BornaBiro/ESP32_WeatherPaper/Images/20211017_192531.jpg

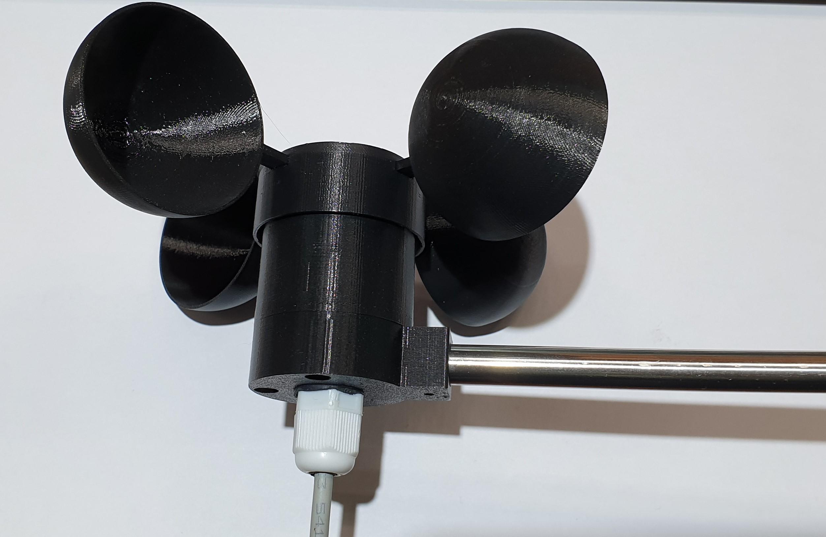
Images/20211017_192531.jpg
