BornaBiro/ESP32_WeatherPaper/Outdoor Unit Files/3D Models/FreeCAD files/WindSpeed/Notes.txt

- IR Interupter used: https://soldered.com/product/photointerrupter-itr9608/
- Wind Cups: 15% infil, 4 perimeters minimum, 0.1mm layers, black PETG (MUST BE BLACK!)
