BornaBiro/ESP32_WeatherPaper/Images/20211017_200331.jpg

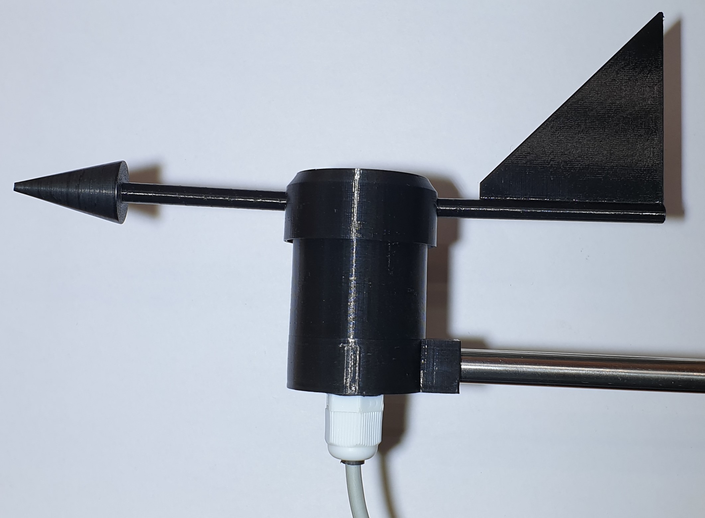
Images/20211017_200331.jpg
