BornaBiro/ESP32_WeatherPaper/Images/20220807_165750.jpg

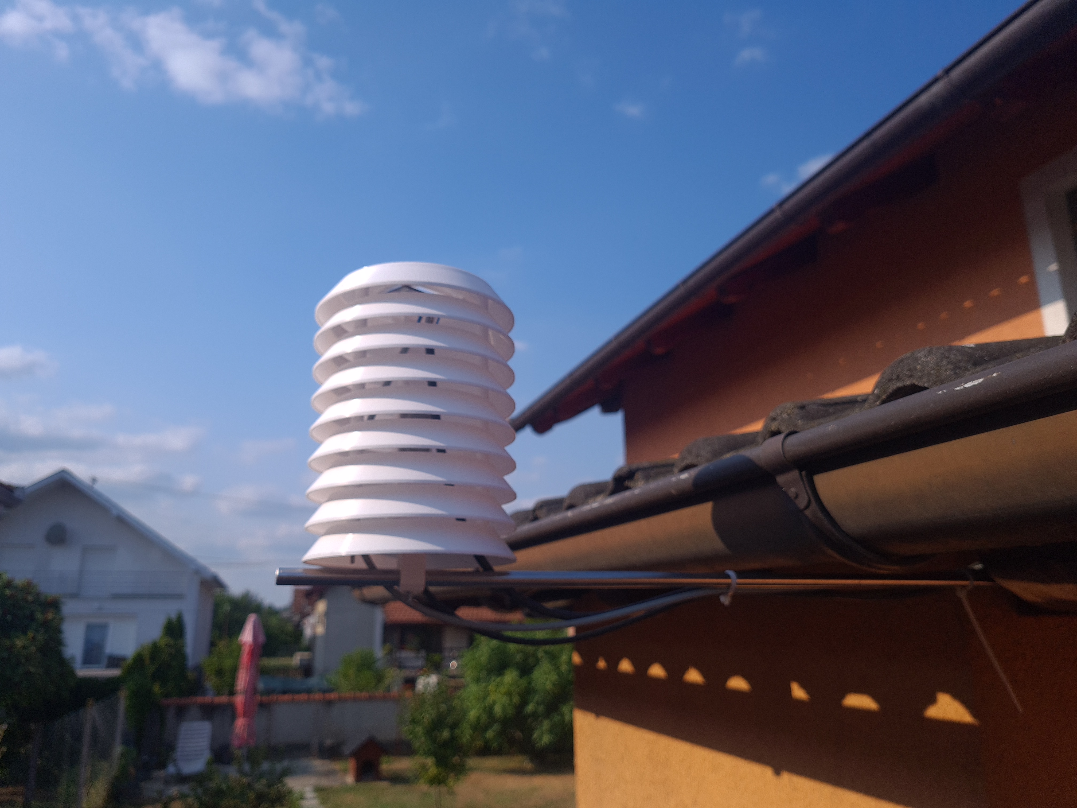
Images/20220807_165750.jpg
