BornaBiro/ESP32_WeatherPaper/Images/20220807_165809.jpg

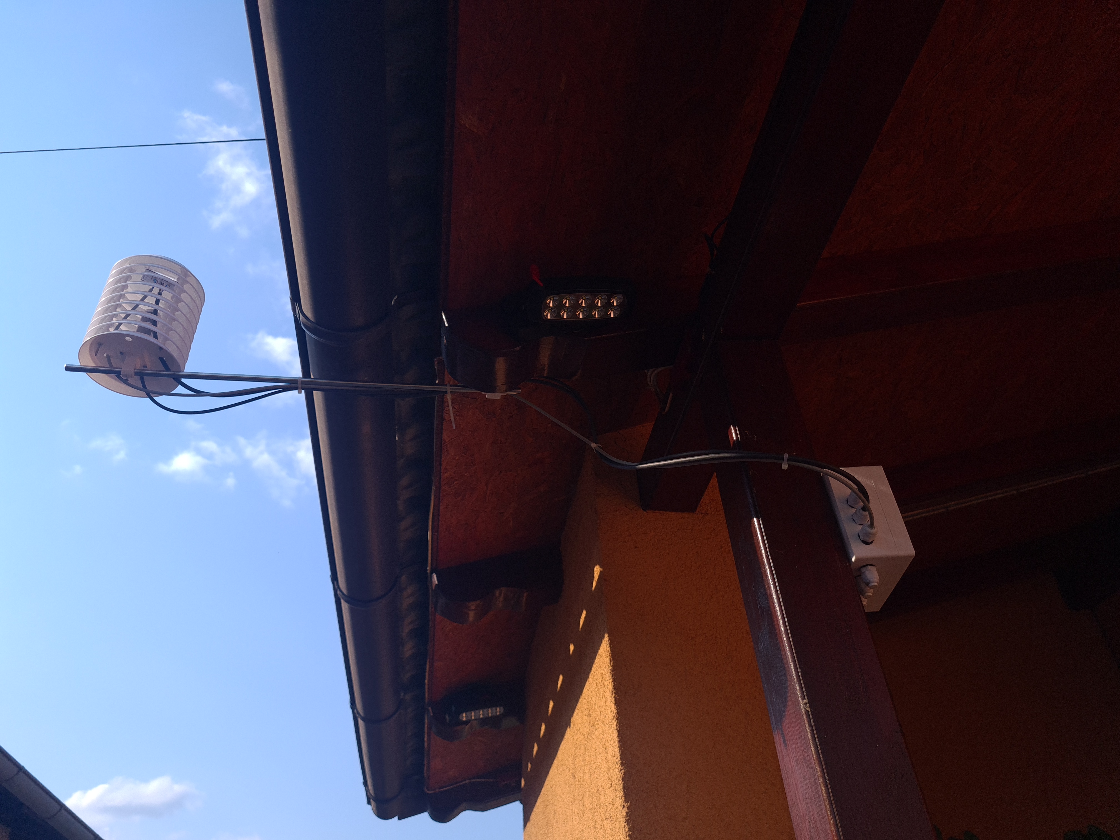
Images/20220807_165809.jpg
