BornaBiro/ESP32_WeatherPaper/Images/20220807_165829.jpg

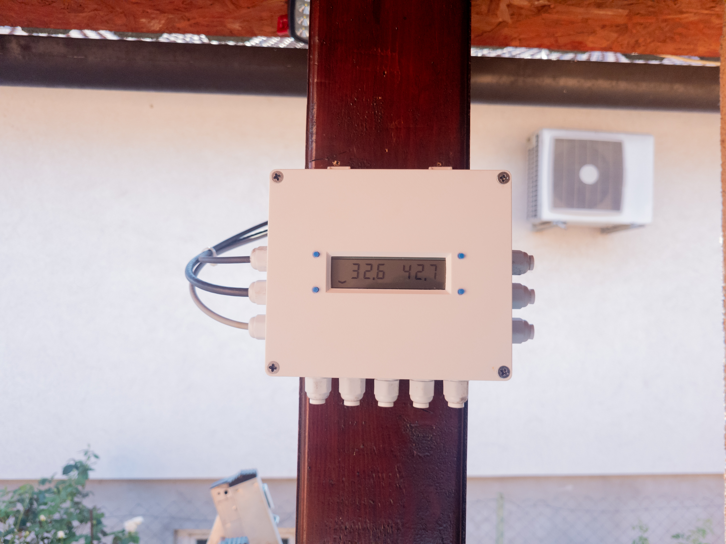
Images/20220807_165829.jpg
