BornaBiro/ESP32_WeatherPaper/Images/IMG_20220727_213647_678.jpg

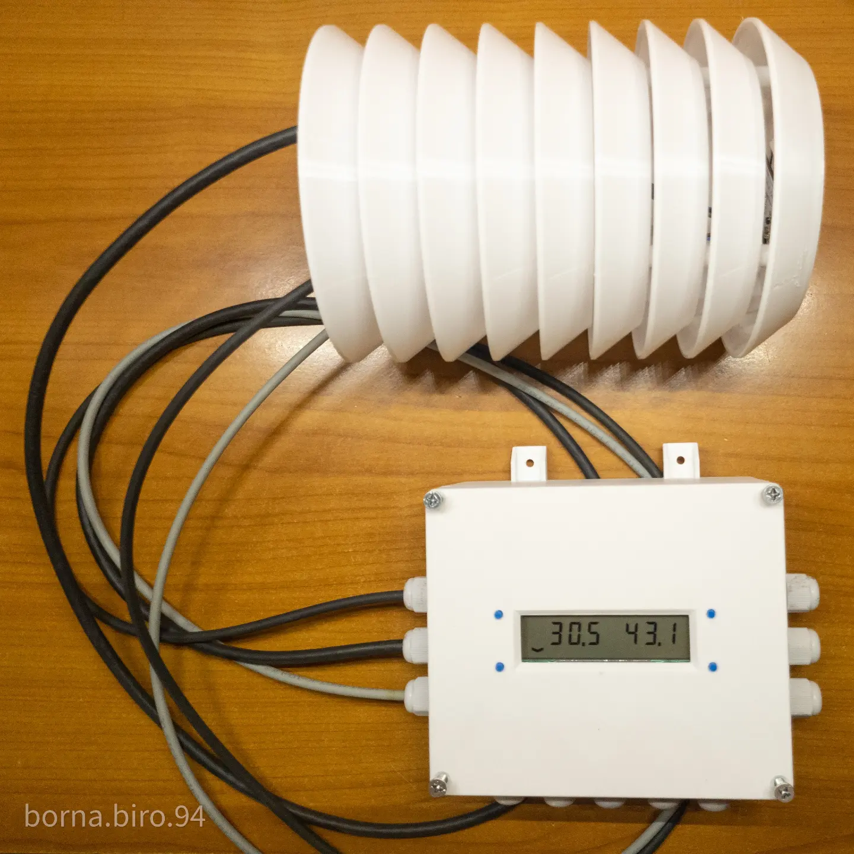
Images/IMG_20220727_213647_678.jpg
