BornaBiro/ESP32_WeatherPaper/Images/IMG_20220727_213647_747.jpg

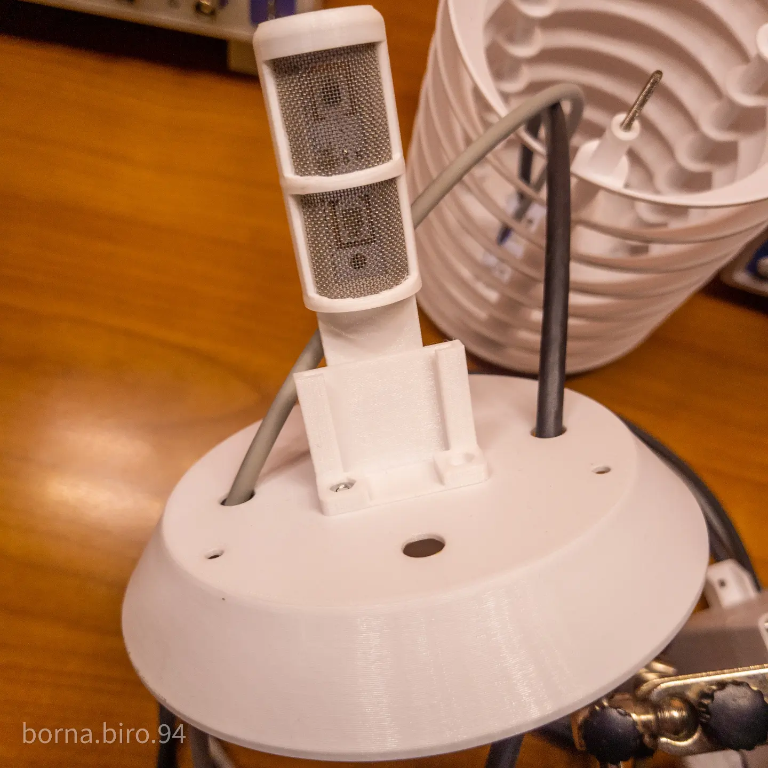
Images/IMG_20220727_213647_747.jpg
