BornaBiro/ESP32_WeatherPaper/Images/IMG_20220727_213647_826.jpg

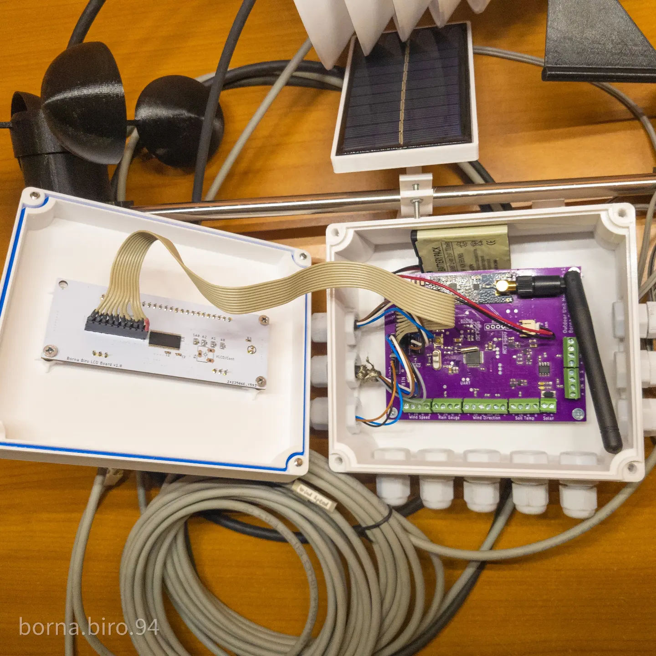
Images/IMG_20220727_213647_826.jpg
