BornaBiro/ESP32_WeatherPaper/Images/PSX_20211029_150437.jpg

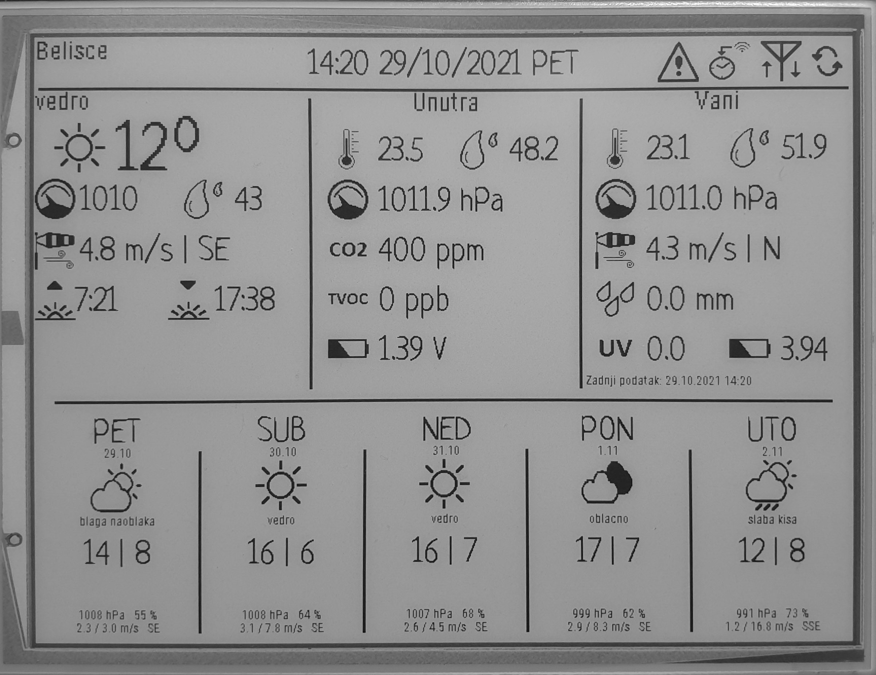
Images/PSX_20211029_150437.jpg
