BornaBiro/ESP32_WeatherPaper/Images/PSX_20211029_150859.jpg

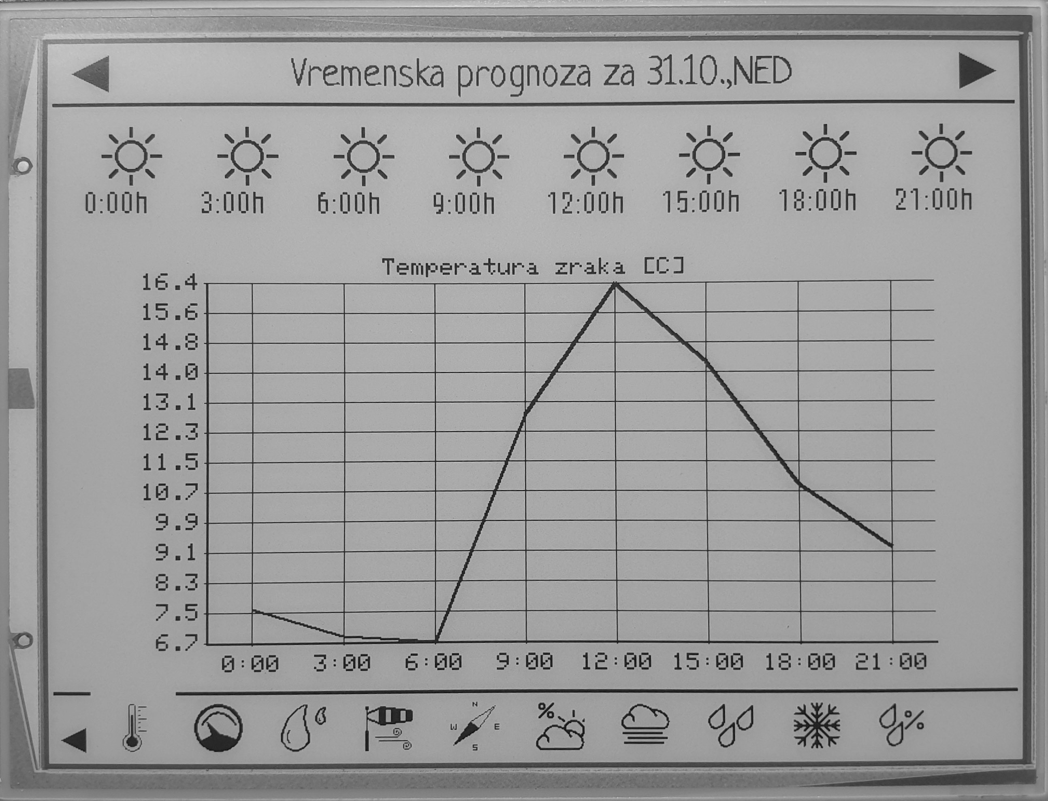
Images/PSX_20211029_150859.jpg
