BornaBiro/ESP32_WeatherPaper/Images/PSX_20211029_155932.jpg

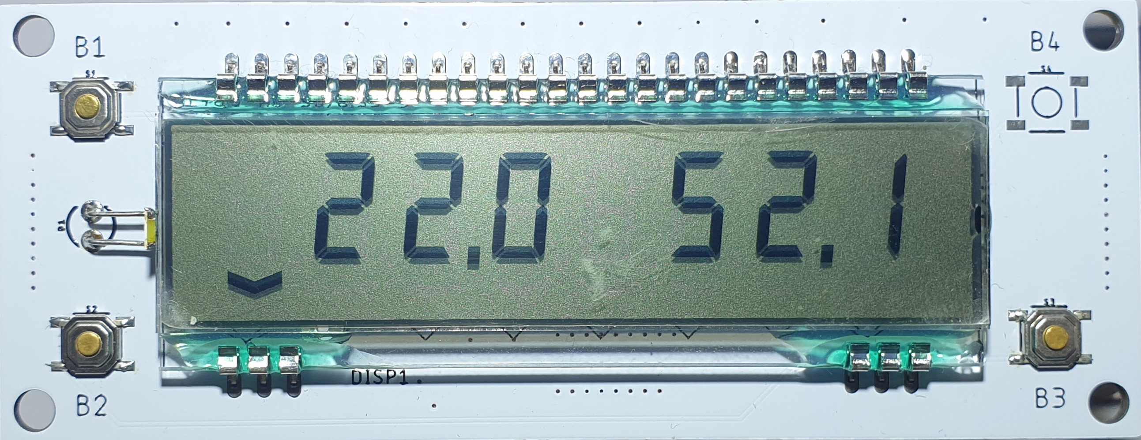
Images/PSX_20211029_155932.jpg
