BornaBiro/ESP32_WeatherPaper/Indoor Unit Files/Case, 3D models/FreeCAD files/Indoor_unit_solar.FCStd

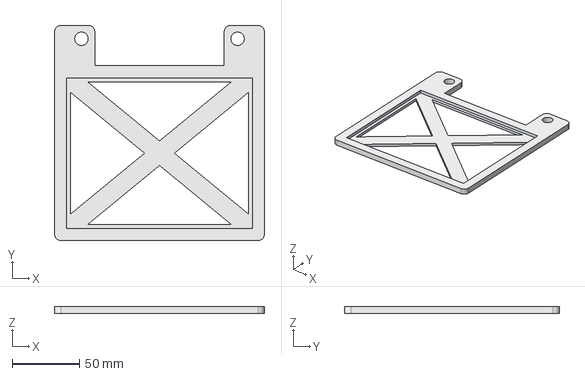
[picture p15: CAD file, 2022-05-21]
Indoor Unit Files/Case, 3D models/FreeCAD files/Indoor_unit_solar.FCStd
156.0 x 160.0 x 5.50 mm
