BornaBiro/ESP32_WeatherPaper/Outdoor Unit Files/3D Models/FreeCAD files/Outdoor Unit Case/button_v2.FCStd

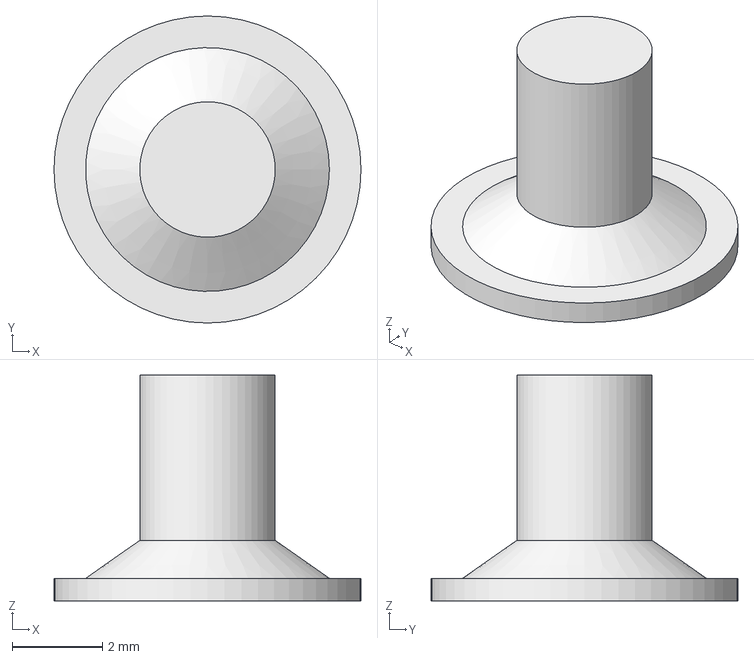
[picture p16: CAD file, 2023-01-04]
Outdoor Unit Files/3D Models/FreeCAD files/Outdoor Unit Case/button_v2.FCStd
6.80 x 6.80 x 5.00 mm
