BornaBiro/ESP32_WeatherPaper/Outdoor Unit Files/3D Models/FreeCAD files/Radiation Shield/Stevenson_screen_v2_top.FCStd

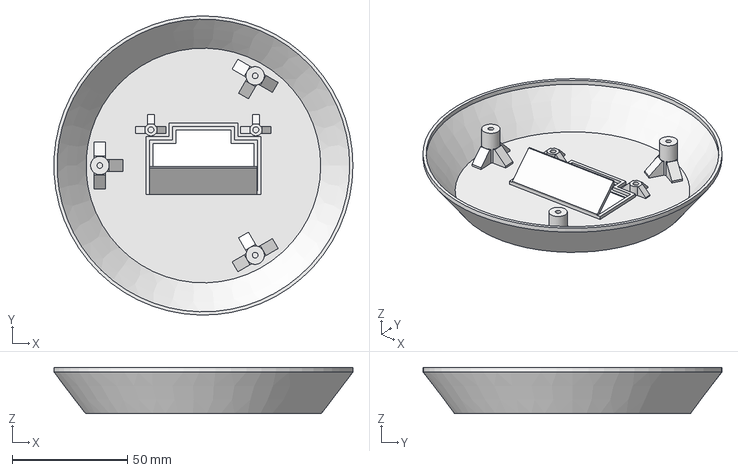
[picture p17: CAD file, 2023-01-04]
Outdoor Unit Files/3D Models/FreeCAD files/Radiation Shield/Stevenson_screen_v2_top.FCStd
129.9 x 130.0 x 20.0 mm
