BornaBiro/ESP32_WeatherPaper/Outdoor Unit Files/3D Models/FreeCAD files/Solar Panel/solar_panel_clip.FCStd

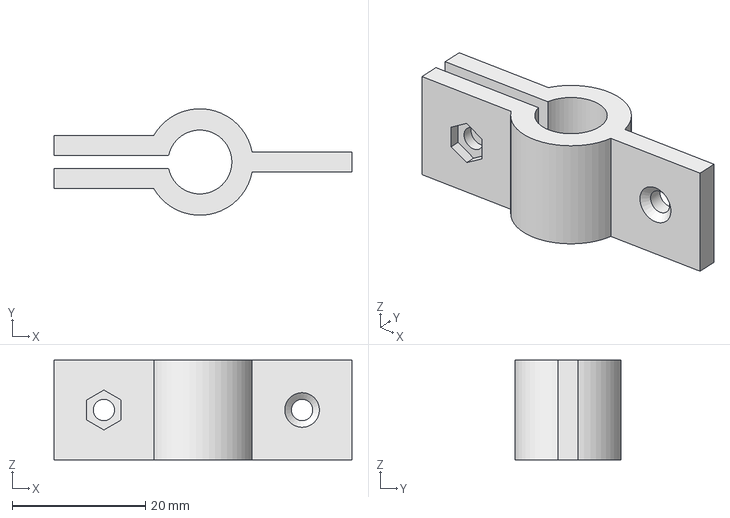
[picture p18: CAD file, 2023-01-04]
Outdoor Unit Files/3D Models/FreeCAD files/Solar Panel/solar_panel_clip.FCStd
44.8 x 16.0 x 15.0 mm
