BornaBiro/ESP32_WeatherPaper/Outdoor Unit Files/3D Models/FreeCAD files/WindDirection/windDirectionSensorHousing.FCStd

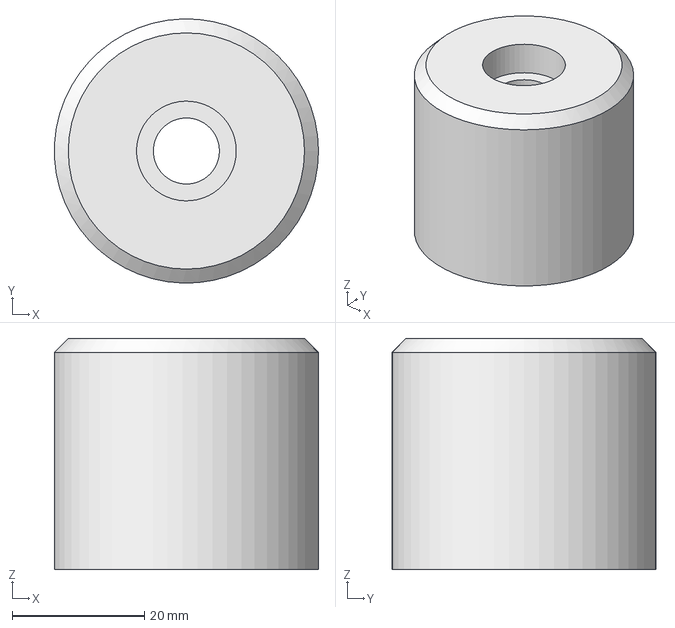
[picture p19: CAD file, 2023-01-04]
Outdoor Unit Files/3D Models/FreeCAD files/WindDirection/windDirectionSensorHousing.FCStd
40.0 x 40.0 x 35.0 mm
