BornaBiro/ESP32_WeatherPaper/Indoor Unit Files/Case, 3D models/FreeCAD files/epaperFrameV5.FCStd

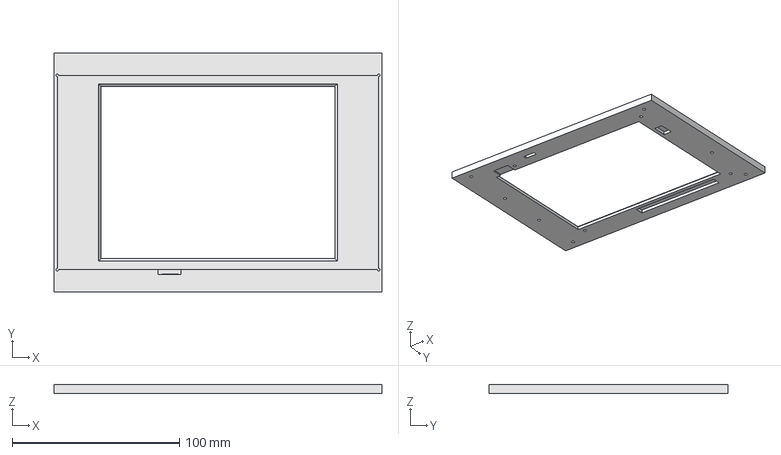
[picture p21: CAD file, 2022-05-21]
Indoor Unit Files/Case, 3D models/FreeCAD files/epaperFrameV5.FCStd
196.0 x 143.0 x 5.50 mm
