BornaBiro/ESP32_WeatherPaper/Outdoor Unit Files/3D Models/FreeCAD files/Outdoor Unit Case/outdoor_unit_case_topv2_1.FCStd

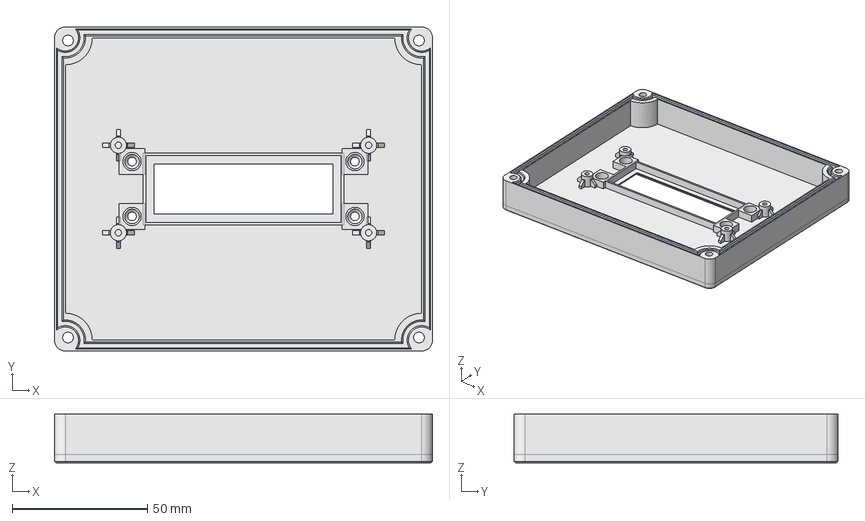
[picture p22: CAD file, 2023-01-04]
Outdoor Unit Files/3D Models/FreeCAD files/Outdoor Unit Case/outdoor_unit_case_topv2_1.FCStd
140.0 x 120.0 x 18.0 mm
