BornaBiro/ESP32_WeatherPaper/Outdoor Unit Files/3D Models/FreeCAD files/Radiation Shield/Stevenson_screen_bottom_v2.FCStd

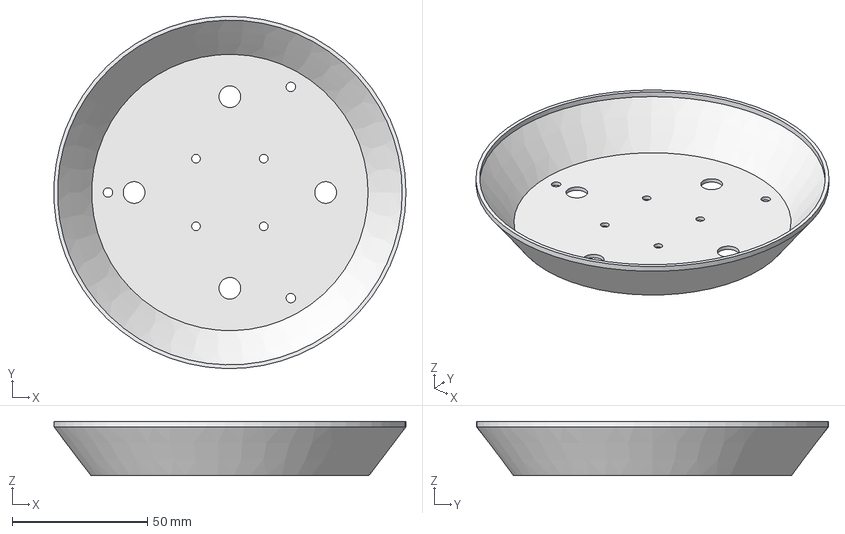
[picture p23: CAD file, 2023-01-04]
Outdoor Unit Files/3D Models/FreeCAD files/Radiation Shield/Stevenson_screen_bottom_v2.FCStd
129.9 x 130.0 x 20.0 mm
