BornaBiro/ESP32_WeatherPaper/Outdoor Unit Files/3D Models/FreeCAD files/Solar Panel/Outdoor_solar_panel.FCStd

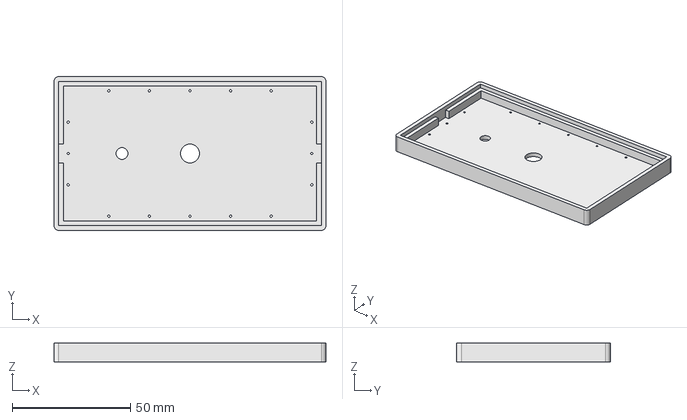
[picture p24: CAD file, 2023-01-04]
Outdoor Unit Files/3D Models/FreeCAD files/Solar Panel/Outdoor_solar_panel.FCStd
115.0 x 65.0 x 8.00 mm
