BornaBiro/ESP32_WeatherPaper/Outdoor Unit Files/3D Models/FreeCAD files/WindDirection/windDirectionArrowTopv2.FCStd

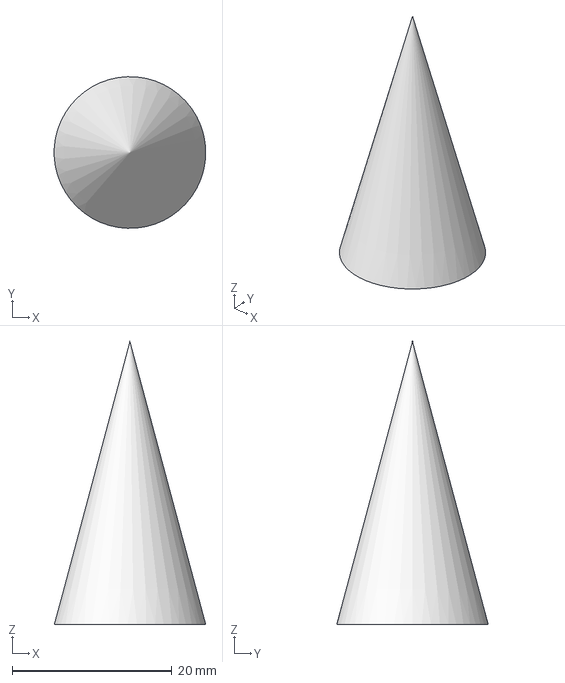
[picture p25: CAD file, 2023-01-04]
Outdoor Unit Files/3D Models/FreeCAD files/WindDirection/windDirectionArrowTopv2.FCStd
19.0 x 19.0 x 35.5 mm
