BornaBiro/ESP32_WeatherPaper/Outdoor Unit Files/3D Models/FreeCAD files/WindSpeed/windSensorHousingBottomv2.FCStd

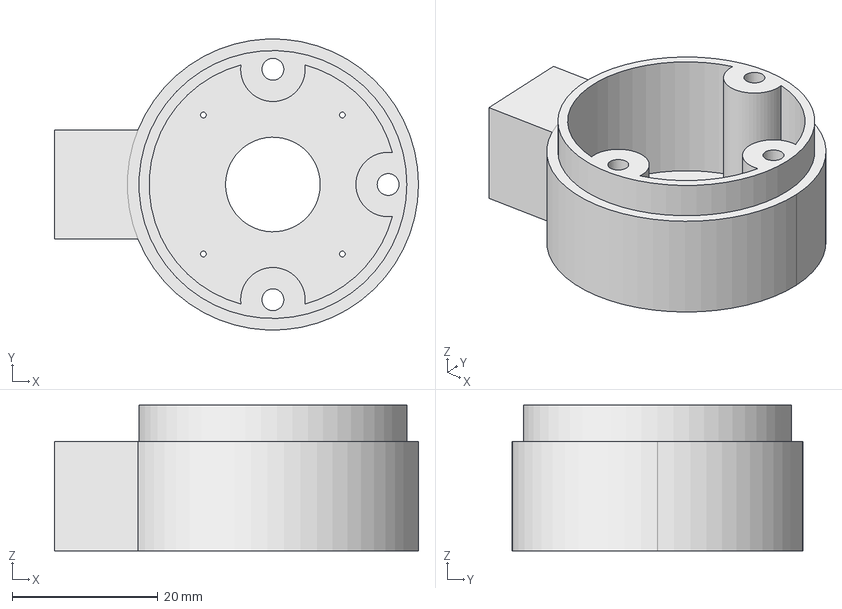
[picture p26: CAD file, 2023-01-04]
Outdoor Unit Files/3D Models/FreeCAD files/WindSpeed/windSensorHousingBottomv2.FCStd
50.0 x 40.0 x 20.0 mm
