BornaBiro/ESP32_WeatherPaper/Indoor Unit Files/Case, 3D models/FreeCAD files/epaperFrameBackCover.FCStd

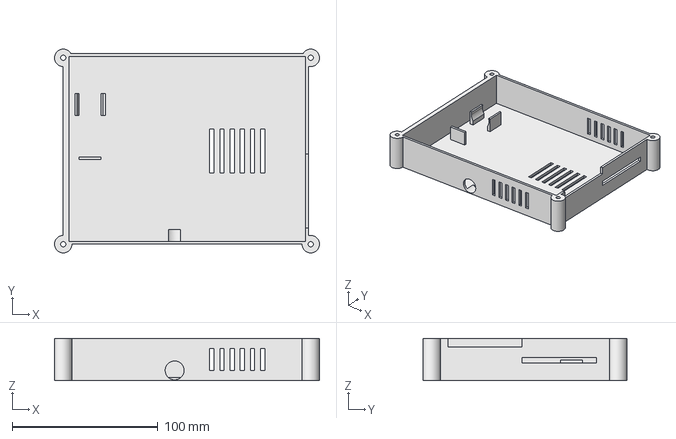
[picture p27: CAD file, 2022-05-21]
Indoor Unit Files/Case, 3D models/FreeCAD files/epaperFrameBackCover.FCStd
182.0 x 140.0 x 29.0 mm
