BornaBiro/ESP32_WeatherPaper/Outdoor Unit Files/3D Models/FreeCAD files/Radiation Shield/Stevenson_screen_middle_v1.FCStd

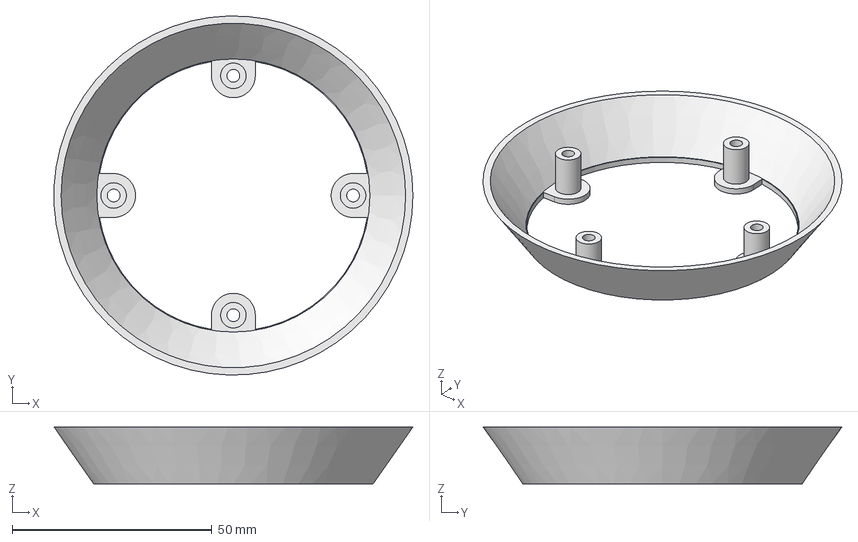
[picture p28: CAD file, 2023-01-04]
Outdoor Unit Files/3D Models/FreeCAD files/Radiation Shield/Stevenson_screen_middle_v1.FCStd
89.9 x 90.0 x 14.3 mm
