BornaBiro/ESP32_WeatherPaper/Outdoor Unit Files/3D Models/FreeCAD files/Solar Panel/Ball_joint1.FCStd

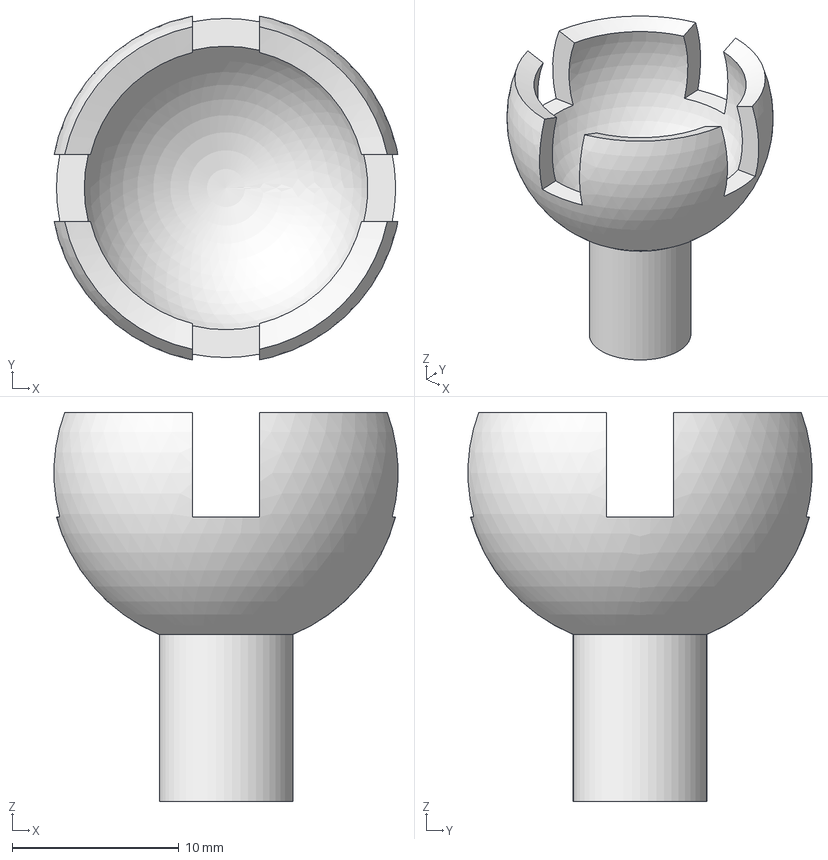
[picture p29: CAD file, 2023-01-04]
Outdoor Unit Files/3D Models/FreeCAD files/Solar Panel/Ball_joint1.FCStd
20.6 x 20.6 x 23.3 mm
