BornaBiro/ESP32_WeatherPaper/Outdoor Unit Files/3D Models/FreeCAD files/WindDirection/windDIrectionShaft.FCStd

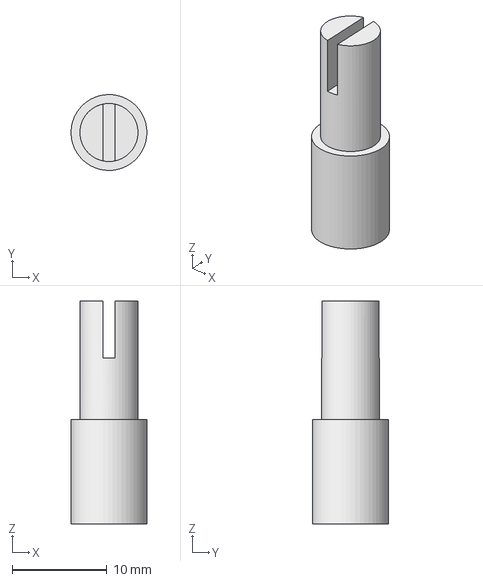
[picture p30: CAD file, 2023-01-04]
Outdoor Unit Files/3D Models/FreeCAD files/WindDirection/windDIrectionShaft.FCStd
7.99 x 8.00 x 23.5 mm
