BornaBiro/ESP32_WeatherPaper/Outdoor Unit Files/3D Models/FreeCAD files/WindSpeed/bearingHolderWindv3.FCStd

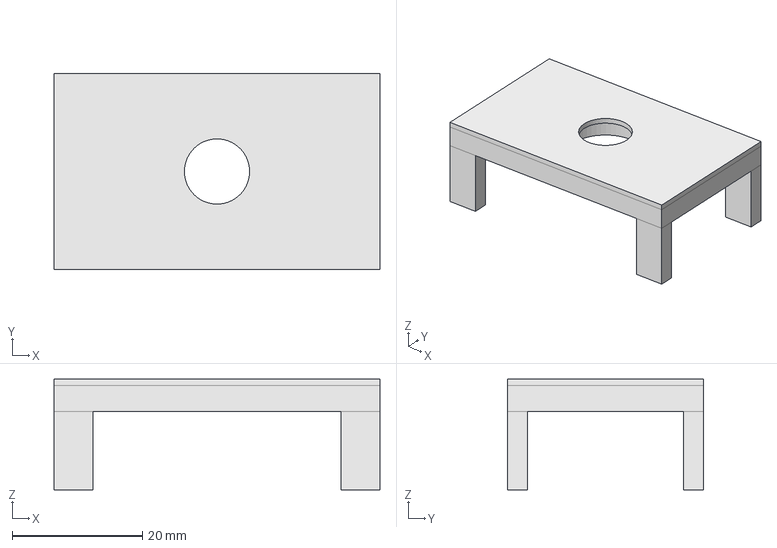
[picture p31: CAD file, 2023-01-04]
Outdoor Unit Files/3D Models/FreeCAD files/WindSpeed/bearingHolderWindv3.FCStd
50.0 x 30.0 x 17.0 mm
