BornaBiro/ESP32_WeatherPaper/Outdoor Unit Files/3D Models/FreeCAD files/Outdoor Unit Case/buttonRing.FCStd

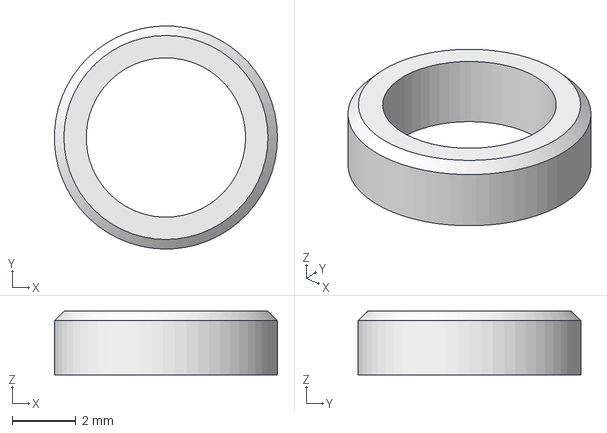
[picture p32: CAD file, 2023-01-04]
Outdoor Unit Files/3D Models/FreeCAD files/Outdoor Unit Case/buttonRing.FCStd
7.00 x 7.00 x 2.00 mm
