BornaBiro/ESP32_WeatherPaper/Outdoor Unit Files/3D Models/FreeCAD files/Radiation Shield/SensorMesh.FCStd

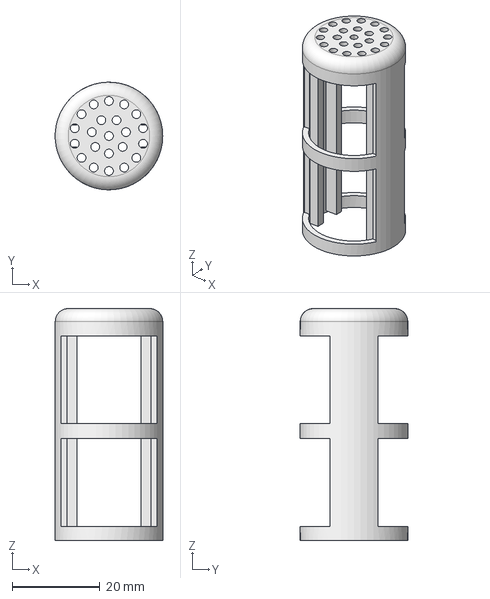
[picture p33: CAD file, 2023-01-04]
Outdoor Unit Files/3D Models/FreeCAD files/Radiation Shield/SensorMesh.FCStd
24.6 x 24.6 x 53.0 mm
