BornaBiro/ESP32_WeatherPaper/Outdoor Unit Files/3D Models/FreeCAD files/Solar Panel/Ball_joint2.FCStd

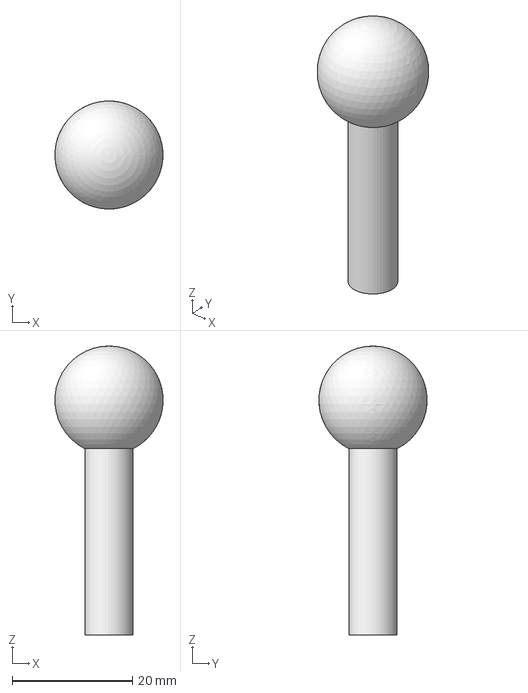
[picture p34: CAD file, 2023-01-04]
Outdoor Unit Files/3D Models/FreeCAD files/Solar Panel/Ball_joint2.FCStd
18.0 x 17.9 x 48.0 mm
