BornaBiro/ESP32_WeatherPaper/Outdoor Unit Files/3D Models/FreeCAD files/WindDirection/windDirectionArrowTop.FCStd

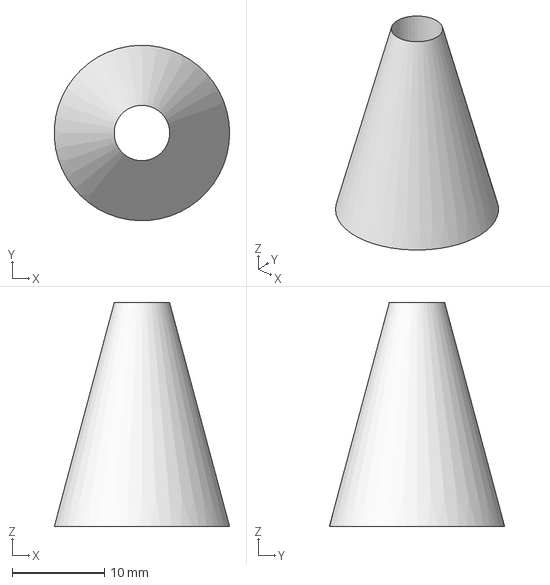
[picture p35: CAD file, 2023-01-04]
Outdoor Unit Files/3D Models/FreeCAD files/WindDirection/windDirectionArrowTop.FCStd
19.0 x 19.0 x 24.3 mm
