BornaBiro/ESP32_WeatherPaper/Outdoor Unit Files/3D Models/FreeCAD files/WindSpeed/windCupHolderv5.FCStd

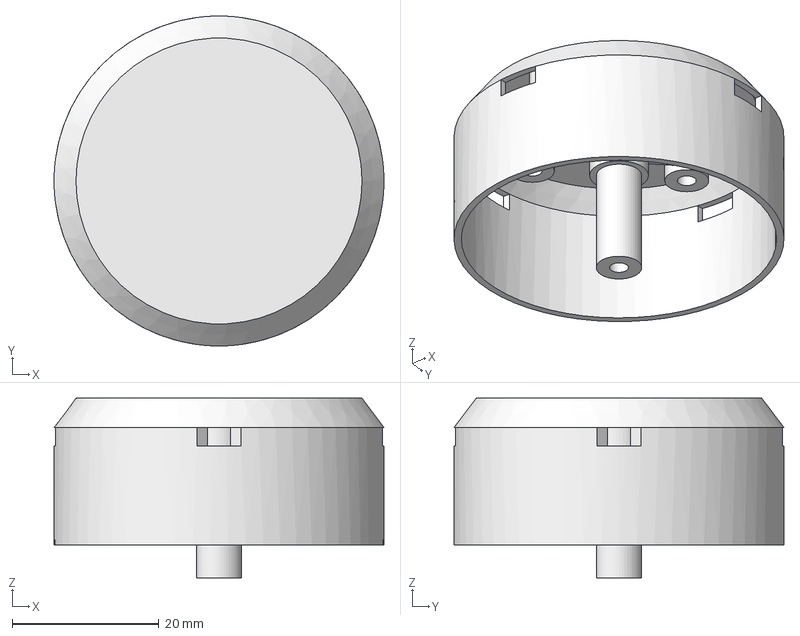
[picture p36: CAD file, 2023-01-04]
Outdoor Unit Files/3D Models/FreeCAD files/WindSpeed/windCupHolderv5.FCStd
45.0 x 45.0 x 24.5 mm
