BornaBiro/ESP32_WeatherPaper/Outdoor Unit Files/3D Models/FreeCAD files/Outdoor Unit Case/cablePlug.FCStd

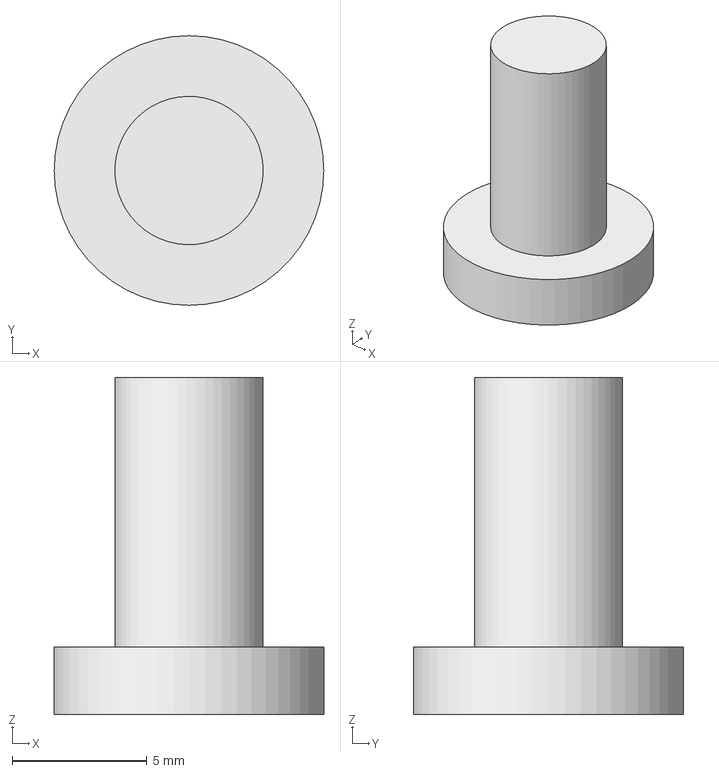
[picture p37: CAD file, 2023-01-04]
Outdoor Unit Files/3D Models/FreeCAD files/Outdoor Unit Case/cablePlug.FCStd
10.00 x 10.0 x 12.5 mm
