BornaBiro/ESP32_WeatherPaper/Outdoor Unit Files/3D Models/FreeCAD files/Radiation Shield/Stevenson_screen_holder_rod.FCStd

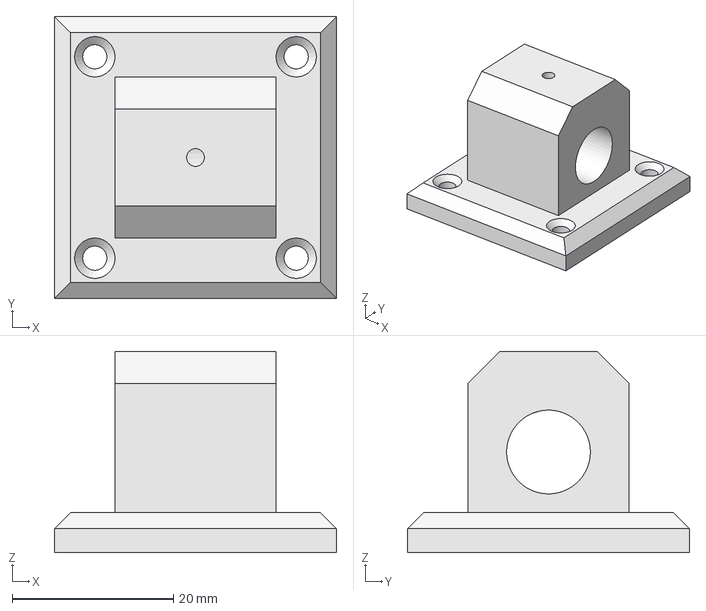
[picture p38: CAD file, 2023-01-04]
Outdoor Unit Files/3D Models/FreeCAD files/Radiation Shield/Stevenson_screen_holder_rod.FCStd
35.0 x 35.0 x 25.0 mm
