BornaBiro/ESP32_WeatherPaper/Outdoor Unit Files/3D Models/FreeCAD files/WindDirection/windDirectionWing.FCStd

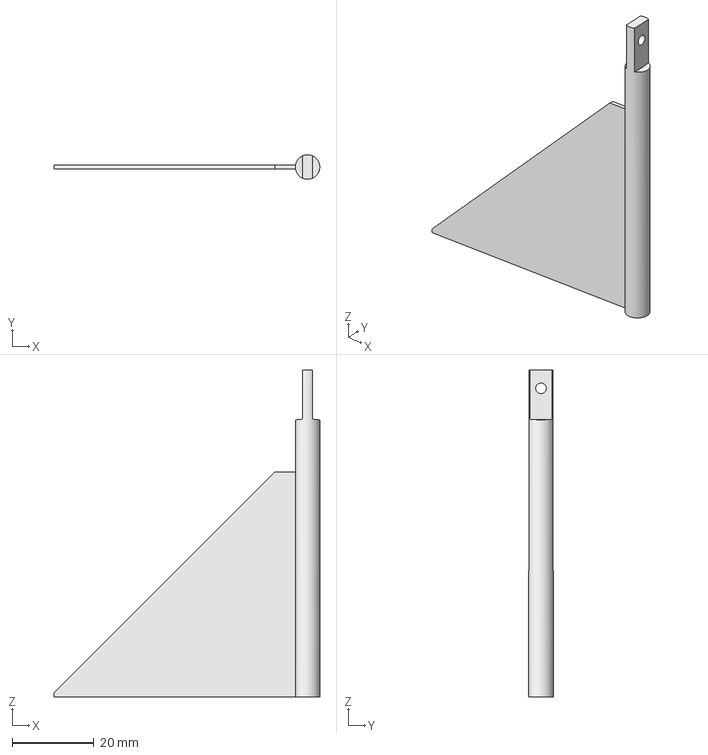
[picture p39: CAD file, 2023-01-04]
Outdoor Unit Files/3D Models/FreeCAD files/WindDirection/windDirectionWing.FCStd
65.0 x 6.00 x 80.0 mm
