BornaBiro/ESP32_WeatherPaper/Outdoor Unit Files/3D Models/FreeCAD files/WindSpeed/windSensorHousing.FCStd

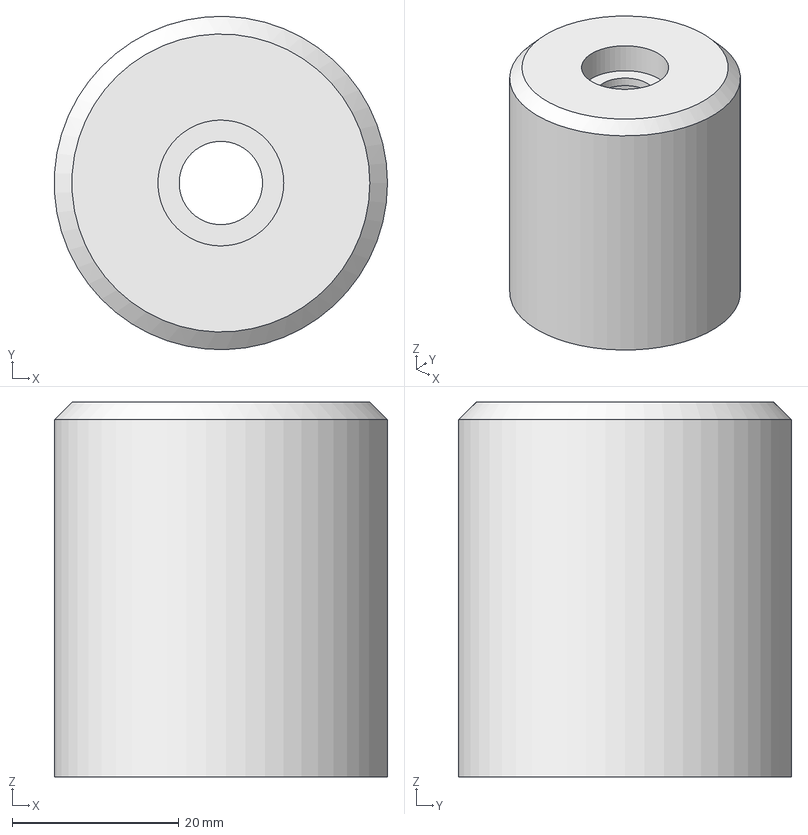
[picture p40: CAD file, 2023-01-04]
Outdoor Unit Files/3D Models/FreeCAD files/WindSpeed/windSensorHousing.FCStd
40.0 x 40.0 x 45.0 mm
