BornaBiro/ESP32_WeatherPaper/Outdoor Unit Files/3D Models/FreeCAD files/Outdoor Unit Case/button_rod.FCStd

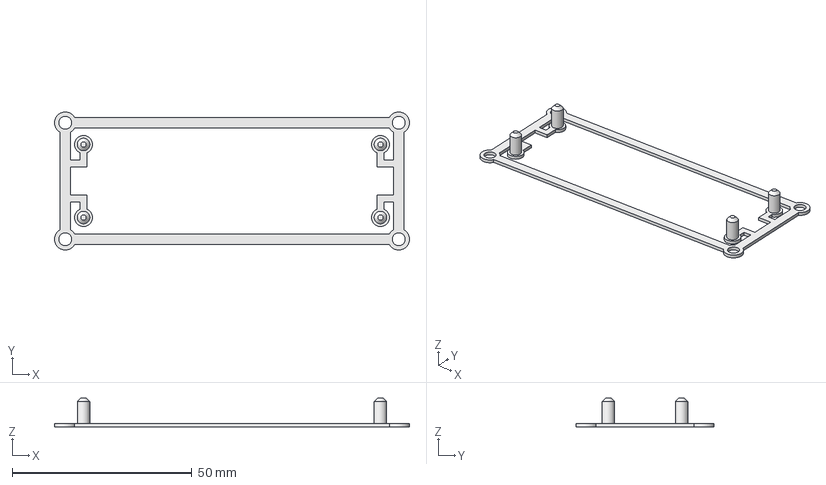
[picture p41: CAD file, 2023-01-04]
Outdoor Unit Files/3D Models/FreeCAD files/Outdoor Unit Case/button_rod.FCStd
98.7 x 38.4 x 8.00 mm
