BornaBiro/ESP32_WeatherPaper/Outdoor Unit Files/3D Models/FreeCAD files/Radiation Shield/Stevenson_screen_holder_v2.1.FCStd

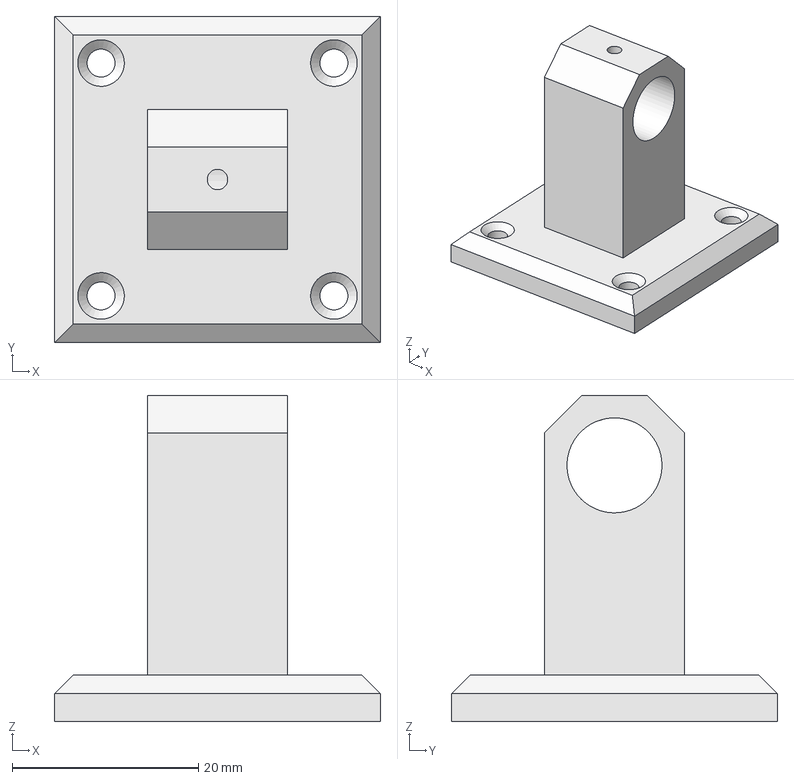
[picture p42: CAD file, 2023-01-04]
Outdoor Unit Files/3D Models/FreeCAD files/Radiation Shield/Stevenson_screen_holder_v2.1.FCStd
35.0 x 35.0 x 35.0 mm
