BornaBiro/ESP32_WeatherPaper/Outdoor Unit Files/3D Models/FreeCAD files/WindDirection/windDirectionHolder.FCStd

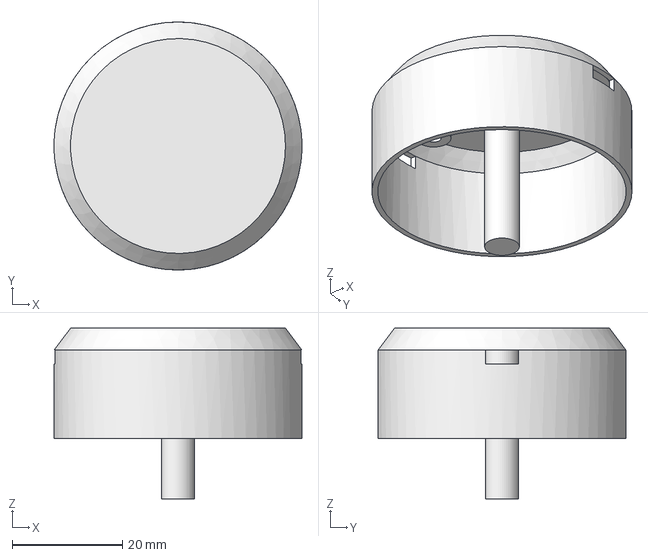
[picture p43: CAD file, 2023-01-04]
Outdoor Unit Files/3D Models/FreeCAD files/WindDirection/windDirectionHolder.FCStd
45.0 x 45.0 x 31.0 mm
