BornaBiro/ESP32_WeatherPaper/Outdoor Unit Files/3D Models/FreeCAD files/WindSpeed/windCupv7.FCStd

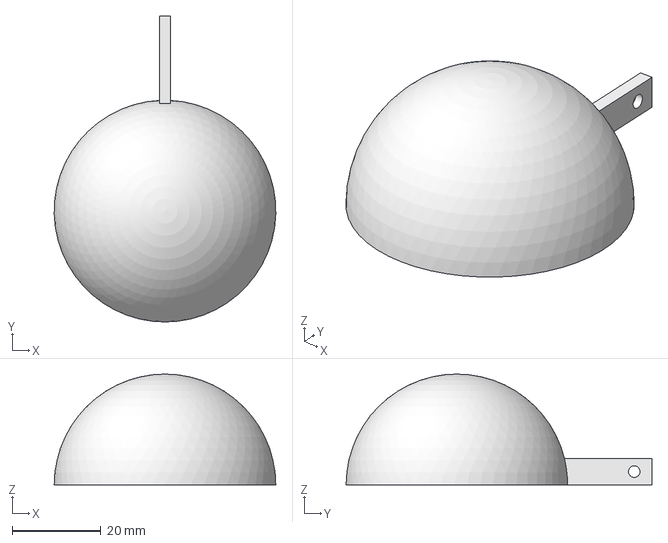
[picture p44: CAD file, 2023-01-04]
Outdoor Unit Files/3D Models/FreeCAD files/WindSpeed/windCupv7.FCStd
50.0 x 69.0 x 25.0 mm
