BornaBiro/ESP32_WeatherPaper/Outdoor Unit Files/3D Models/FreeCAD files/Outdoor Unit Case/outdoor_unit_case.FCStd

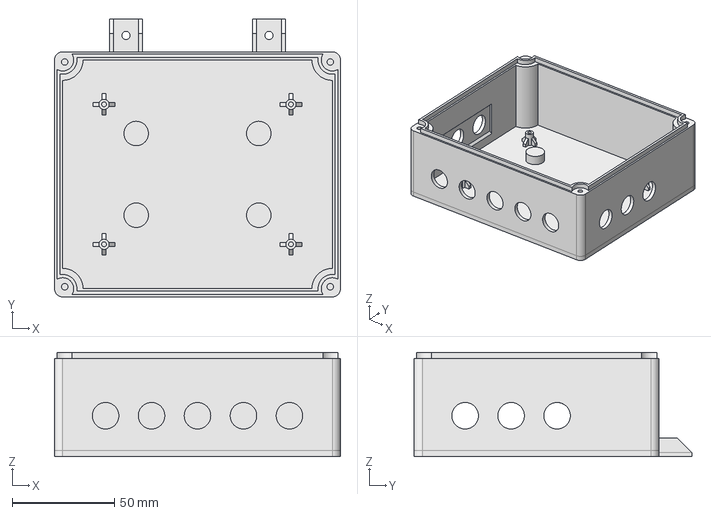
[picture p45: CAD file, 2023-01-04]
Outdoor Unit Files/3D Models/FreeCAD files/Outdoor Unit Case/outdoor_unit_case.FCStd
140.0 x 136.0 x 51.0 mm
