BornaBiro/ESP32_WeatherPaper/Outdoor Unit Files/3D Models/FreeCAD files/WindSpeed/windShaftv3.FCStd

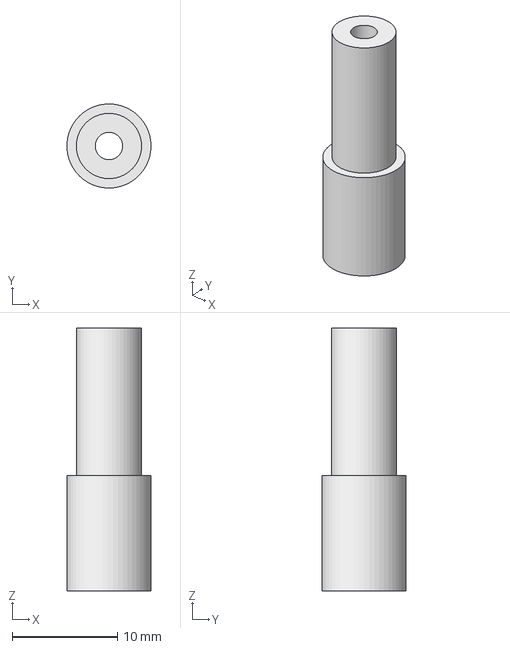
[picture p48: CAD file, 2023-01-04]
Outdoor Unit Files/3D Models/FreeCAD files/WindSpeed/windShaftv3.FCStd
7.99 x 8.00 x 25.0 mm
