BornaBiro/ESP32_WeatherPaper/Outdoor Unit Files/3D Models/FreeCAD files/Radiation Shield/PCB_Holder_v2.1.FCStd

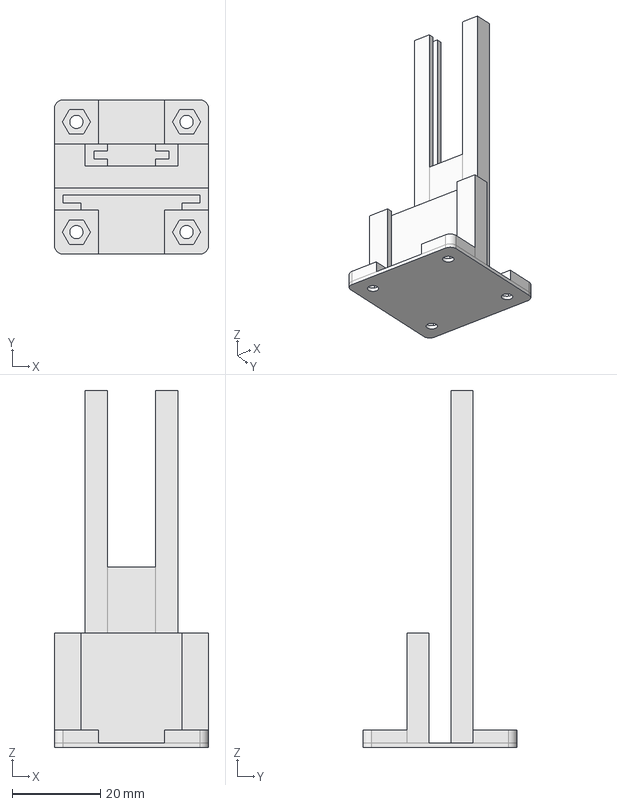
[picture p49: CAD file, 2023-01-04]
Outdoor Unit Files/3D Models/FreeCAD files/Radiation Shield/PCB_Holder_v2.1.FCStd
35.0 x 35.0 x 81.0 mm
