BornaBiro/ESP32_WeatherPaper/Outdoor Unit Files/3D Models/FreeCAD files/WindSpeed/windSensorHolder.FCStd

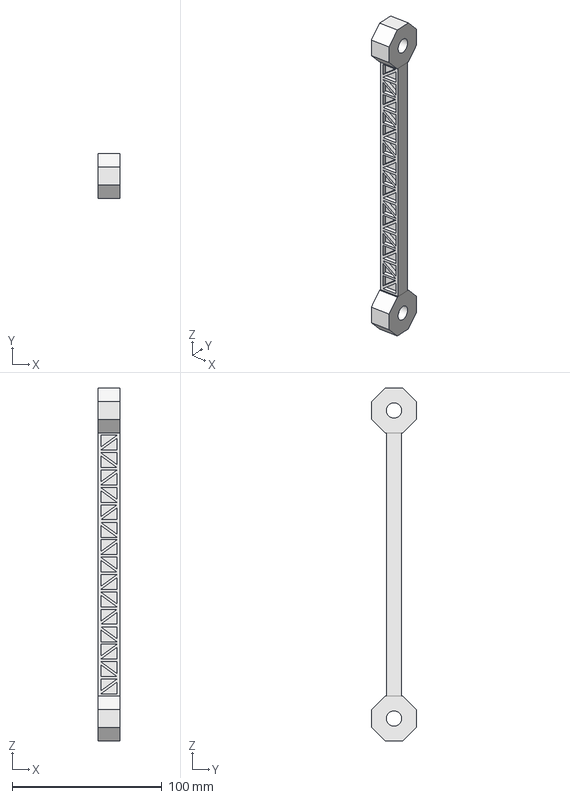
[picture p51: CAD file, 2023-01-04]
Outdoor Unit Files/3D Models/FreeCAD files/WindSpeed/windSensorHolder.FCStd
15.0 x 30.0 x 236.0 mm
