BornaBiro/ESP32_WeatherPaper/Outdoor Unit Files/3D Models/FreeCAD files/WindDirection/windDirectionArrowHolder.FCStd

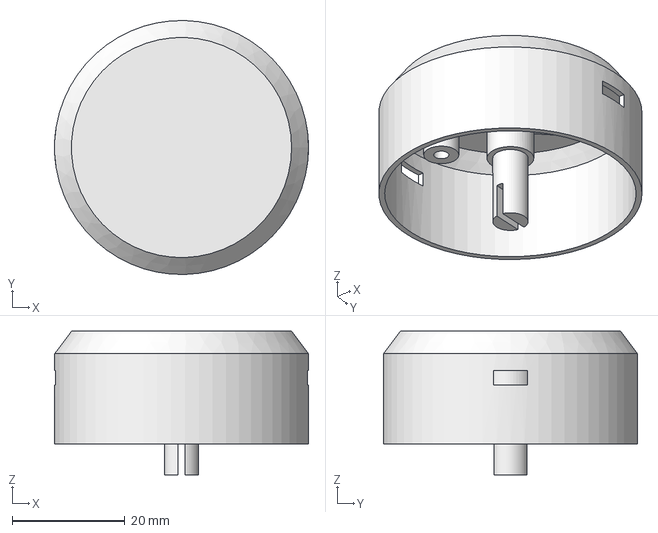
[picture p52: CAD file, 2023-01-04]
Outdoor Unit Files/3D Models/FreeCAD files/WindDirection/windDirectionArrowHolder.FCStd
45.0 x 45.0 x 25.5 mm
