BornaBiro/ESP32_WeatherPaper/Outdoor Unit Files/3D Models/FreeCAD files/WindSpeed/WindGear3.FCStd

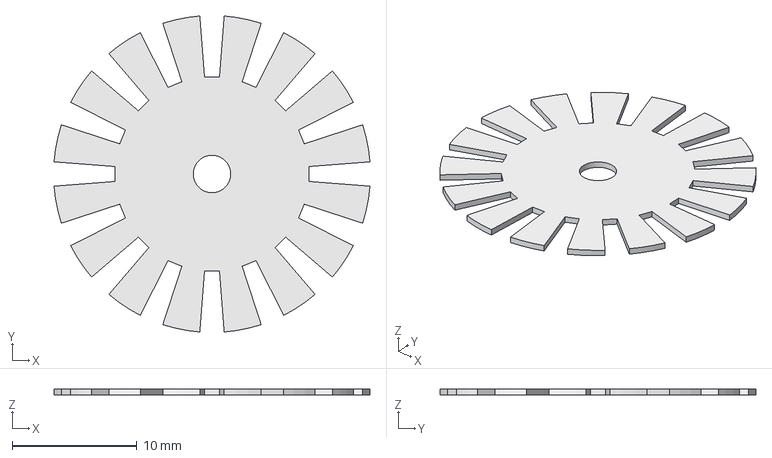
[picture p53: CAD file, 2023-01-04]
Outdoor Unit Files/3D Models/FreeCAD files/WindSpeed/WindGear3.FCStd
25.3 x 25.3 x 0.5 mm
