BornaBiro/ESP32_WeatherPaper/(list of files, cad)

Other CAD files:
Indoor Unit Files/Case, 3D models/STL/Indoor_unit_solar.stl
Indoor Unit Files/Case, 3D models/STL/epaperFrameBackCover.stl
Indoor Unit Files/Case, 3D models/STL/epaperFrameV5.stl
Outdoor Unit Files/3D Models/FreeCAD files/Outdoor Unit Case/buttonv2.FCStd
Outdoor Unit Files/3D Models/FreeCAD files/Outdoor Unit Case/outdoor_unit_case_LCD_Washers.FCStd
