BornaBiro/ESP32_WeatherPaper/Indoor Unit Files/PCB/Indoor_unit_IO_board.brd

## EAGLE design Indoor Unit Files/PCB/Indoor_unit_IO_board.brd (2022-05-21)

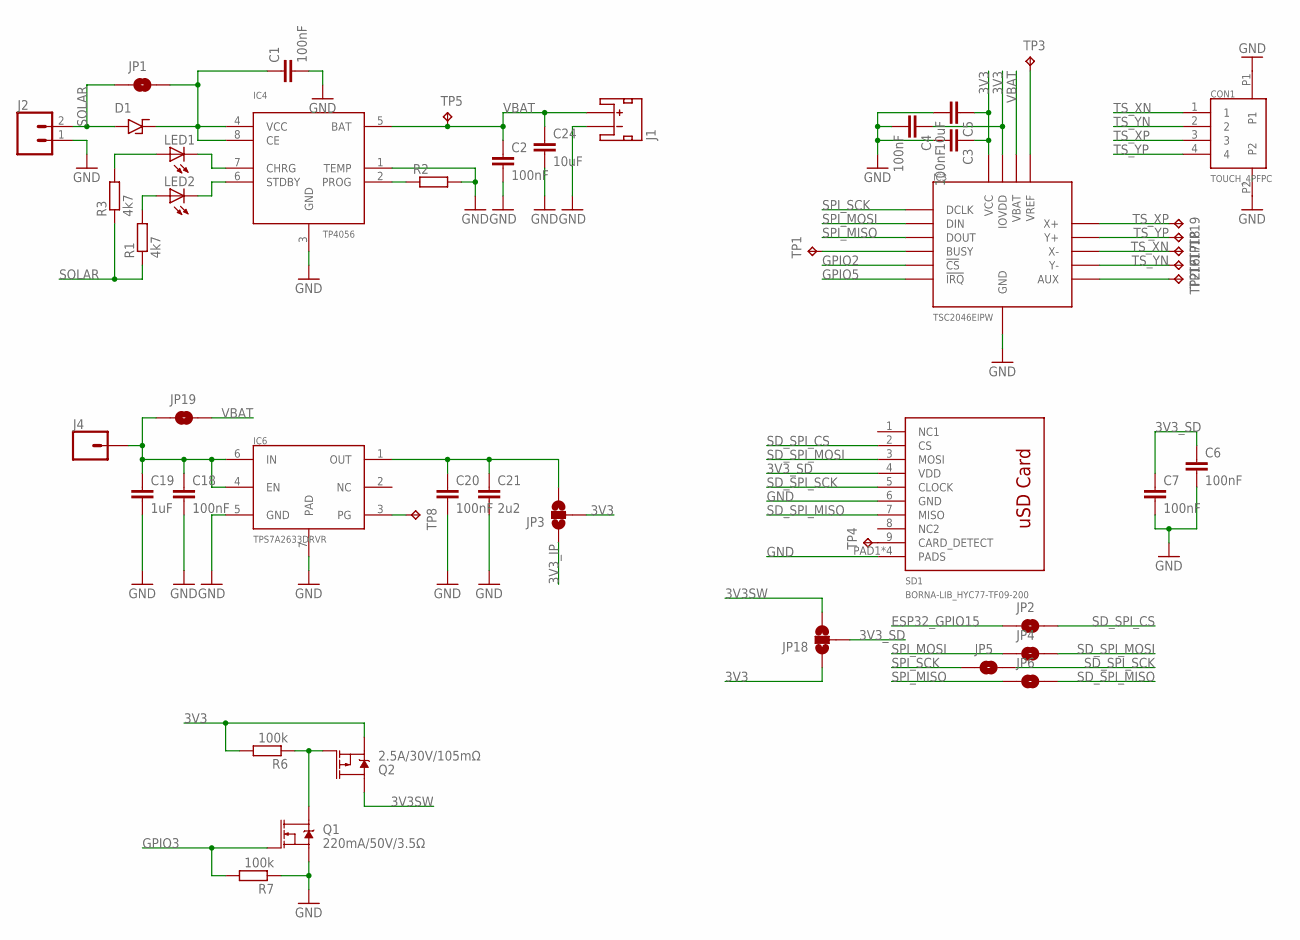
[picture p54: schematic Indoor_unit_IO_board.sch, sheet 1]

Parts:
C1, C2, C3, C4, C6, C7, C18, C20: 100nF; C0603K
C5, C24: 10uF; C1206K
C19: 1uF; C0603K
C21: 2u2; C0603K
CON1: TOUCH_4PFPC
D1: SS24
IC3: TSC2046EIPW; TSSOP16
IC4: TP4056; SOP-8
IC6: TPS7A2633DRVR; WSON-6
J1: JST_2MM_MALE; JST-2-SMD
J2: CONN_02; 1X02
J4: CONN_01; 1X01
JP1, JP2, JP4, JP5, JP6, JP19: JUMPER-SMT_2_NO_SILK; SMT-JUMPER_2_NO_SILK
JP3, JP18: JUMPER-SMT_3_NO_SILK; SMT-JUMPER_3_NO_SILK
LED1, LED2: LEDCHIPLED_0603; CHIPLED_0603
Q1: 220mA/50V/3.5Ω; SOT23-3
Q2: 2.5A/30V/105mΩ; SOT23-3
R1, R3: 4k7; R0603
R2: R-EU_R0603; R0603
R6, R7: 100k; R0603
SD1: BORNA-LIB_HYC77-TF09-200; BORNA-LIB_MICROSD_HOLDER
TP1, TP2, TP3, TP4, TP5, TP8, TP16, TP17, TP18, TP19: TPTP15R; TP15R

Connections:
3V3: C3.1, C4.1, C5.1, IC3.P1 (VCC), IC3.P10 (IOVDD), JP3.2, JP18.1, Q2.2 (S), R6.2; also elsewhere on the board
3V3SW: JP18.3, Q2.3 (D); also elsewhere on the board
3V3_IP: JP3.1; also elsewhere on the board
3V3_SD: C6.1, C7.1, JP18.2, SD1.4 (VDD)
ESP32_GPIO15: JP2.1; also elsewhere on the board
GND: C1.2, C2.2, C3.2, C4.2, C5.2, C6.2, C7.2, C18.2, C19.2, C20.2, C21.2, C24.2, CON1.P1, CON1.P2, IC3.P6 (GND), IC4.1 (TEMP), IC4.3 (GND), IC6.5 (GND), IC6.7 (PAD), J1.1 (-), J2.1, Q1.2 (S), R2.2, R7.1, SD1.6 (GND), SD1.PAD1 (PADS), SD1.PAD2 (PADS), SD1.PAD3 (PADS), SD1.PAD4 (PADS); also elsewhere on the board
GPIO2: IC3.P15 (!CS); also elsewhere on the board
GPIO3: Q1.1 (G), R7.2; also elsewhere on the board
GPIO5: IC3.P11 (!IRQ); also elsewhere on the board
unnamed: C18.1, C19.1, IC6.4 (EN), IC6.6 (IN), J4.1, JP19.1
unnamed: C1.1, D1.C, IC4.4 (VCC), IC4.8 (CE), JP1.2
unnamed: IC4.7 (CHRG), LED1.C
unnamed: IC4.6 (STDBY), LED2.C
unnamed: IC4.2 (PROG), R2.1
unnamed: LED1.A, R3.2
unnamed: LED2.A, R1.2
unnamed: IC6.3 (PG), TP8.TP
unnamed: IC3.P8 (AUX), TP2.TP
unnamed: IC3.P9 (VREF), TP3.TP
unnamed: SD1.9 (CARD_DETECT), TP4.TP
unnamed: C20.1, C21.1, IC6.1 (OUT), JP3.3
unnamed: Q1.3 (D), Q2.1 (G), R6.1
unnamed: IC3.P13 (BUSY), TP1.TP
SD_SPI_CS: JP2.2, SD1.2 (CS)
SD_SPI_MISO: JP6.2, SD1.7 (MISO)
SD_SPI_MOSI: JP4.2, SD1.3 (MOSI)
SD_SPI_SCK: JP5.2, SD1.5 (CLOCK)
SOLAR: D1.A, J2.2, JP1.1, R1.1, R3.1
SPI_MISO: IC3.P12 (DOUT), JP6.1; also elsewhere on the board
SPI_MOSI: IC3.P14 (DIN), JP4.1; also elsewhere on the board
SPI_SCK: IC3.P16 (DCLK), JP5.1; also elsewhere on the board
TS_XN: CON1.1, IC3.P4 (X-), TP17.TP
TS_XP: CON1.3, IC3.P2 (X+), TP19.TP
TS_YN: CON1.2, IC3.P5 (Y-), TP16.TP
TS_YP: CON1.4, IC3.P3 (Y+), TP18.TP
VBAT: C2.1, C24.1, IC3.P7 (VBAT), IC4.5 (BAT), J1.2 (+), JP19.2, TP5.TP

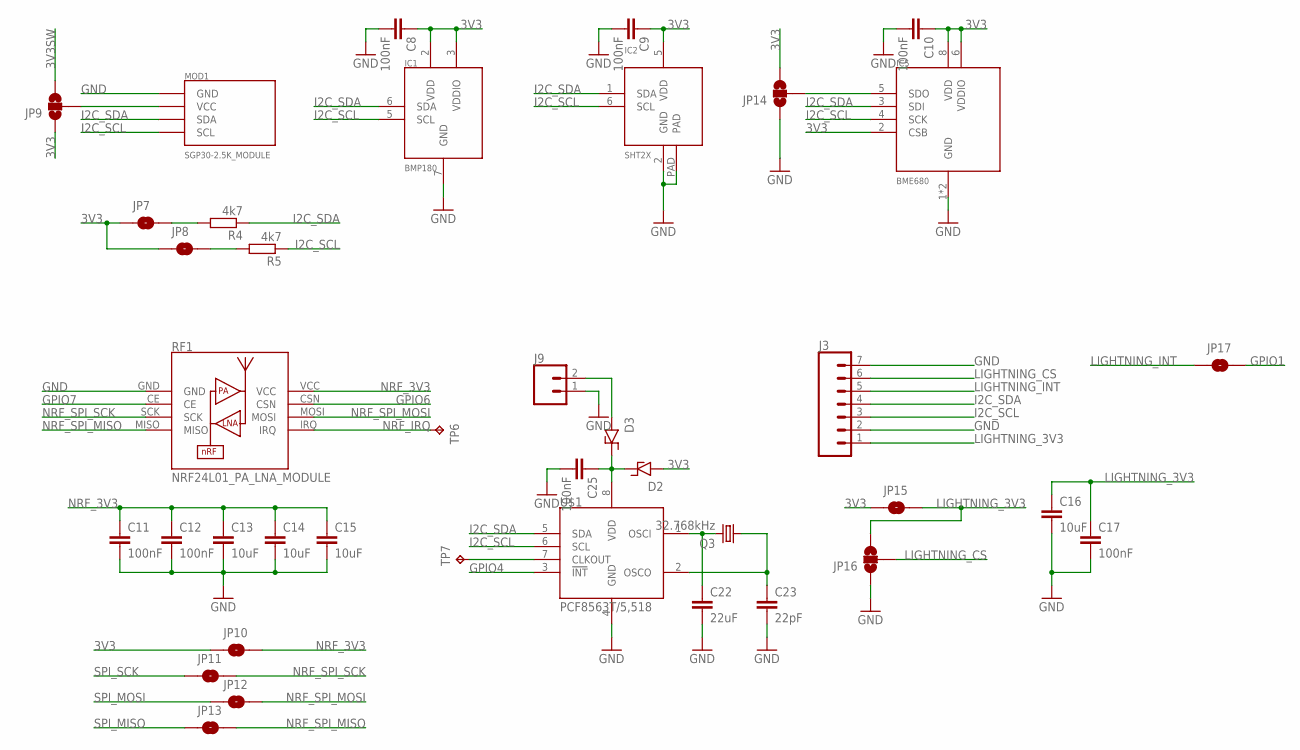
[picture p55: schematic Indoor_unit_IO_board.sch, sheet 2]

Parts:
C8, C9, C10, C11, C12, C17, C25: 100nF; C0603K
C13, C14, C15, C16: 10uF; C1206K
C22: 22uF; C0603K
C23: 22pF; C0603K
D2, D3: SS24
IC1: BMP180
IC2: SHT2X
IC5: BME680
J3: CONN_07; 1X07
J9: CONN_02; 1X02
JP7, JP8, JP10, JP11, JP12, JP13, JP15, JP17: JUMPER-SMT_2_NO_SILK; SMT-JUMPER_2_NO_SILK
JP9, JP14, JP16: JUMPER-SMT_3_NO_SILK; SMT-JUMPER_3_NO_SILK
MOD1: SGP30_ERAD_MODULE
Q3: 32.768kHz; TC26H
R4, R5: 4k7; R0603
RF1: NRF24L01_PA_LNA_MODULE; NRF24L01_PA_LNA
TP6, TP7: TPTP15R; TP15R
U$1: PCF8563T/5,518; SOIC-8

Connections:
3V3: C8.1, C9.1, C10.1, D2.A, IC1.2 (VDD), IC1.3 (VDDIO), IC2.5 (VDD), IC5.2 (CSB), IC5.6 (VDDIO), IC5.8 (VDD), JP7.1, JP8.1, JP9.1, JP10.1, JP14.3, JP15.1; also elsewhere on the board
3V3SW: JP9.3; also elsewhere on the board
GND: C8.2, C9.2, C10.2, C11.2, C12.2, C13.2, C14.2, C15.2, C16.2, C17.2, C22.2, C23.2, C25.2, IC1.7 (GND), IC2.2 (GND), IC2.PAD, IC5.1 (GND), IC5.7 (GND), J3.2, J3.7, J9.1, JP14.1, JP16.1, MOD1.GND, RF1.GND, U$1.4 (GND); also elsewhere on the board
GPIO1: JP17.2; also elsewhere on the board
GPIO4: U$1.3 (!INT); also elsewhere on the board
GPIO6: RF1.CSN; also elsewhere on the board
GPIO7: RF1.CE; also elsewhere on the board
I2C_SCL: IC1.5 (SCL), IC2.6 (SCL), IC5.4 (SCK), J3.3, MOD1.SCL, R5.1, U$1.6 (SCL); also elsewhere on the board
I2C_SDA: IC1.6 (SDA), IC2.1 (SDA), IC5.3 (SDI), J3.4, MOD1.SDA, R4.1, U$1.5 (SDA); also elsewhere on the board
LIGHTNING_3V3: C16.1, C17.1, J3.1, JP15.2, JP16.3
LIGHTNING_CS: J3.6, JP16.2
LIGHTNING_INT: J3.5, JP17.1
unnamed: JP9.2, MOD1.VCC
unnamed: IC5.5 (SDO), JP14.2
unnamed: C25.1, D2.C, D3.C, U$1.8 (VDD)
unnamed: JP7.2, R4.2
unnamed: JP8.2, R5.2
unnamed: TP7.TP, U$1.7 (CLKOUT)
unnamed: C22.1, Q3.2, U$1.1 (OSCI)
unnamed: C23.1, Q3.1, U$1.2 (OSCO)
unnamed: D3.A, J9.2
NRF_3V3: C11.1, C12.1, C13.1, C14.1, C15.1, JP10.2, RF1.VCC
NRF_IRQ: RF1.IRQ, TP6.TP
NRF_SPI_MISO: JP13.2, RF1.MISO
NRF_SPI_MOSI: JP12.2, RF1.MOSI
NRF_SPI_SCK: JP11.2, RF1.SCK
SPI_MISO: JP13.1; also elsewhere on the board
SPI_MOSI: JP12.1; also elsewhere on the board
SPI_SCK: JP11.1; also elsewhere on the board

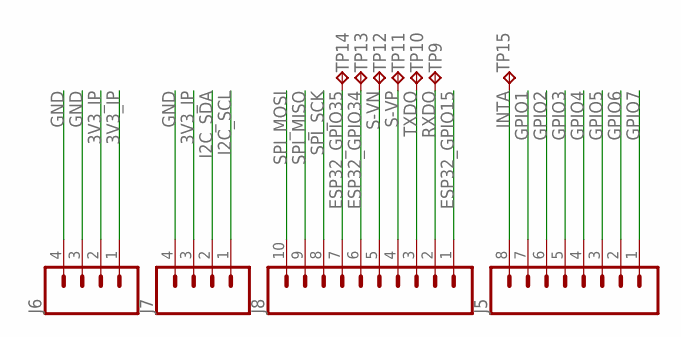
[picture p56: schematic Indoor_unit_IO_board.sch, sheet 3]

Parts:
J5: CONN_08"; 1X08
J6, J7: CONN_04; 1X04
J8: CONN_10"; 1X10
TP9, TP10, TP11, TP12, TP13, TP14, TP15: TPTP15R; TP15R

Connections:
3V3_IP: J6.1, J6.2, J7.3; also elsewhere on the board
ESP32_GPIO15: J8.1; also elsewhere on the board
ESP32_GPIO34: J8.6, TP13.TP
ESP32_GPIO35: J8.7, TP14.TP
GND: J6.3, J6.4, J7.4; also elsewhere on the board
GPIO1: J5.7; also elsewhere on the board
GPIO2: J5.6; also elsewhere on the board
GPIO3: J5.5; also elsewhere on the board
GPIO4: J5.4; also elsewhere on the board
GPIO5: J5.3; also elsewhere on the board
GPIO6: J5.2; also elsewhere on the board
GPIO7: J5.1; also elsewhere on the board
I2C_SCL: J7.1; also elsewhere on the board
I2C_SDA: J7.2; also elsewhere on the board
INTA: J5.8, TP15.TP
RXDO: J8.2, TP9.TP
S-VN: J8.5, TP12.TP
S-VP: J8.4, TP11.TP
SPI_MISO: J8.9; also elsewhere on the board
SPI_MOSI: J8.10; also elsewhere on the board
SPI_SCK: J8.8; also elsewhere on the board
TXDO: J8.3, TP10.TP

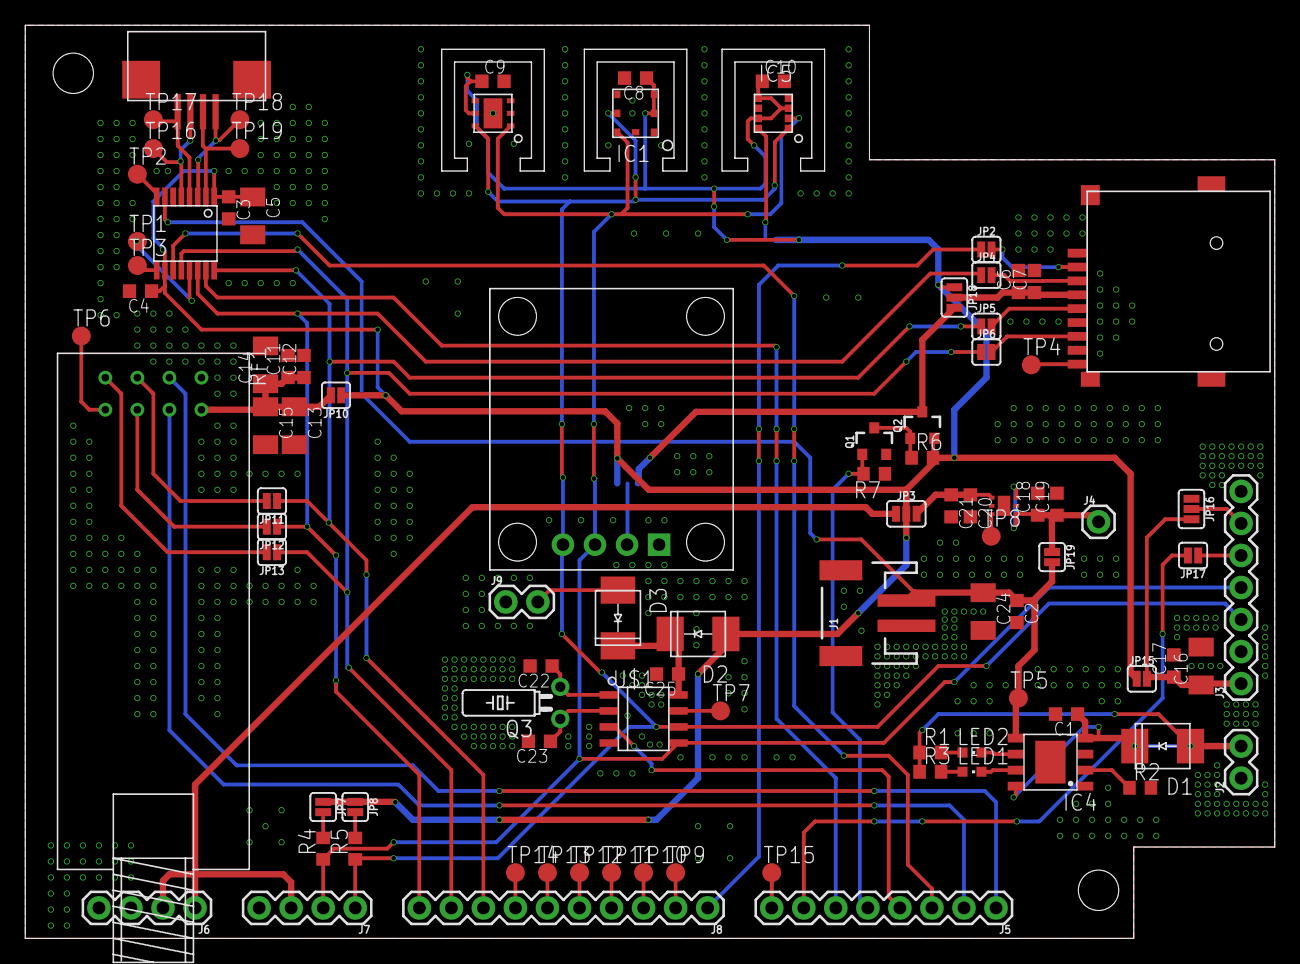
[picture p57: board Indoor_unit_IO_board.brd from above]

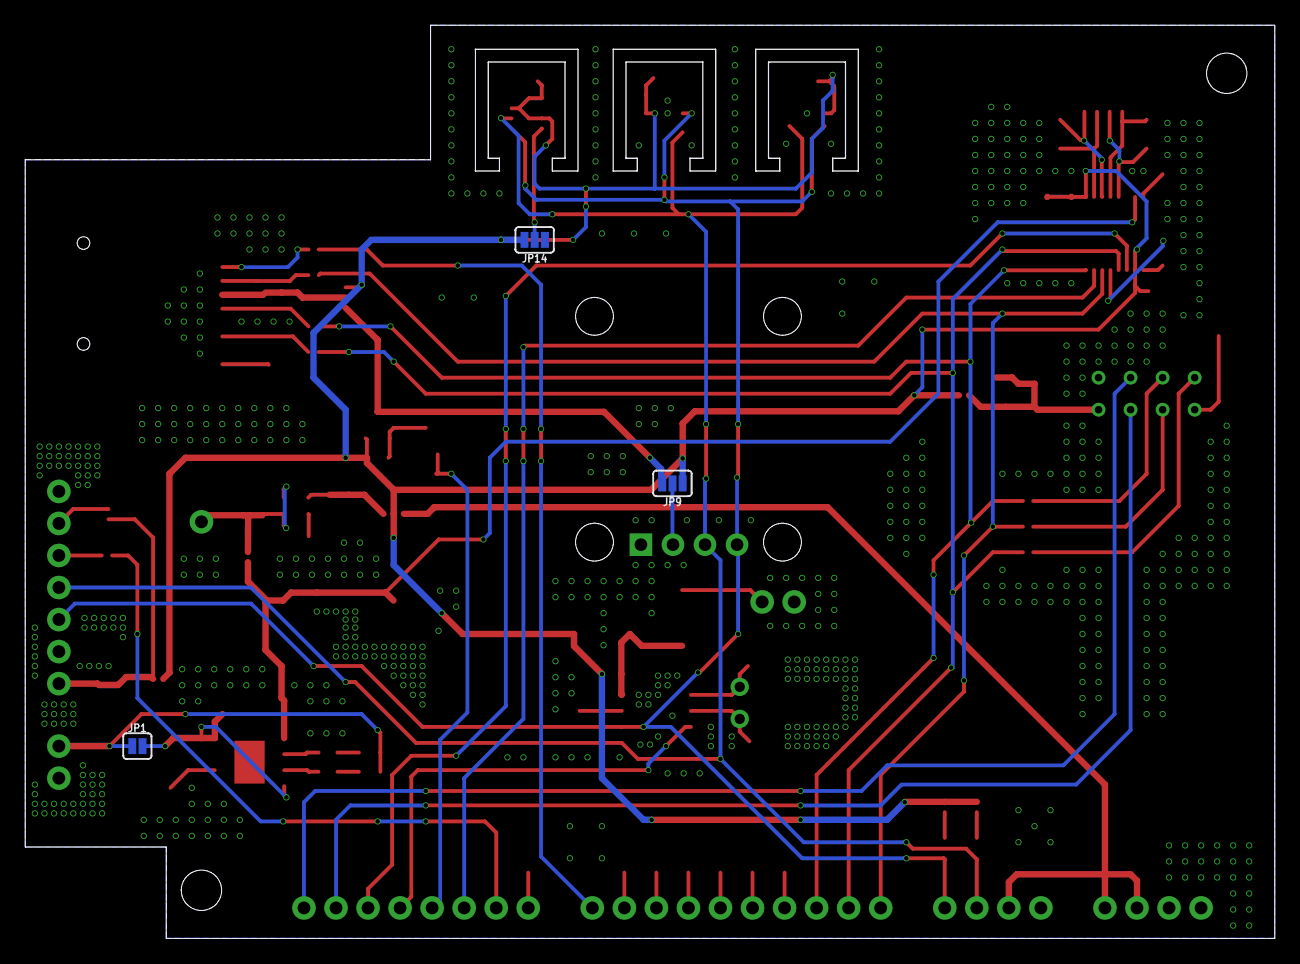
[picture p58: board Indoor_unit_IO_board.brd from below]

Board: 2 copper layers, 99.1 x 72.4 mm, 98 parts (3 on the bottom side), 66 nets.
