BornaBiro/ESP32_WeatherPaper/Outdoor Unit Files/PCB/windSpeedSensorBoard.brd

## EAGLE design Outdoor Unit Files/PCB/windSpeedSensorBoard.brd (2023-01-04)

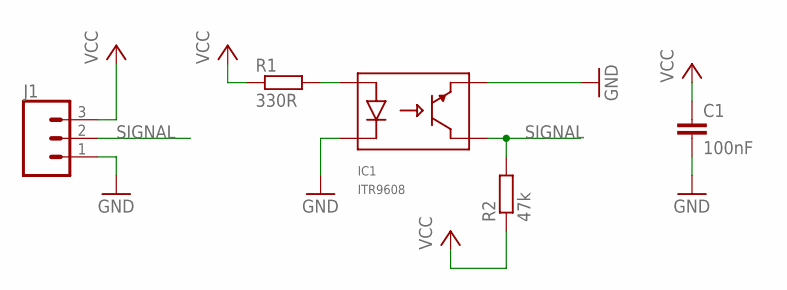
[picture p66: schematic windSpeedSensorBoard.sch]

Parts:
C1: 100nF; C0603K
IC1: ITR9608
J1: CONN_03; 1X03
R1: 330R; R0603
R2: 47k; R0603

Connections:
GND: C1.2, IC1.E, IC1.K, J1.1
unnamed: IC1.A, R1.2
SIGNAL: IC1.C, J1.2, R2.2
VCC: C1.1, J1.3, R1.1, R2.1

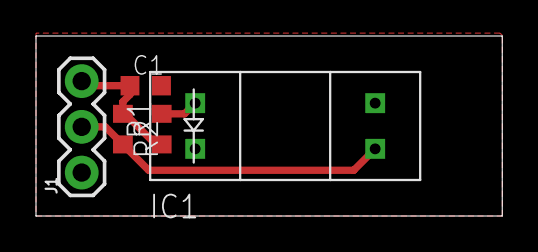
[picture p67: board windSpeedSensorBoard.brd from above]

Board: 2 copper layers, 25.9 x 10.0 mm, 5 parts (0 on the bottom side), 4 nets.
