BornaBiro/ESP32_WeatherPaper/Outdoor Unit Files/PCB/LCD_Board.brd

## EAGLE design Outdoor Unit Files/PCB/LCD_Board.brd (2023-01-04)

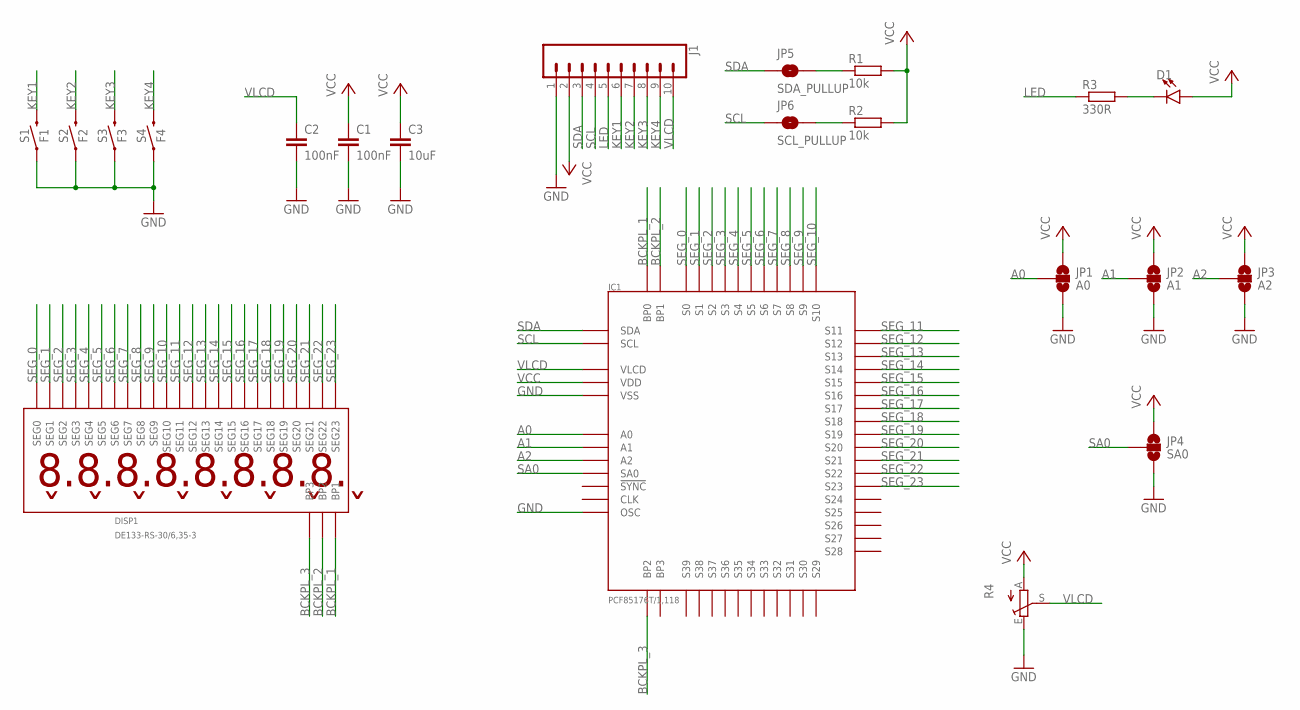
[picture p71: schematic LCD_Board.sch]

Parts:
C1, C2: 100nF; C0603K
C3: 10uF; C1206K
D1: LED3MM; LED_3MM
DISP1: DE133-RS-30/6.35-3
IC1: PCF85176T/1,118; TSSOP56
J1: CONN_10"; 1X10
JP1: A0; SMT-JUMPER_3_NO_SILK
JP2: A1; SMT-JUMPER_3_NO_SILK
JP3: A2; SMT-JUMPER_3_NO_SILK
JP4: SA0; SMT-JUMPER_3_NO_SILK
JP5: SDA_PULLUP; SMT-JUMPER_2_NO_SILK
JP6: SCL_PULLUP; SMT-JUMPER_2_NO_SILK
R1, R2: 10k; R0603
R3: 330R; R0603
R4: TRIM_EU-CA6V; CA6V
S1: F1; TACTILE_SWITCH_SMD_5.2MM
S2: F2; TACTILE_SWITCH_SMD_5.2MM
S3: F3; TACTILE_SWITCH_SMD_5.2MM
S4: F4; TACTILE_SWITCH_SMD_5.2MM

Connections:
A0: IC1.P$50 (A0), JP1.2
A1: IC1.P$51 (A1), JP2.2
A2: IC1.P$52 (A2), JP3.2
BCKPL_1: DISP1.P$25 (BP1), DISP1.P$30 (BP1), IC1.P$56 (BP0)
BCKPL_2: DISP1.P$26 (BP2), DISP1.P$29 (BP2), IC1.P$2 (BP1)
BCKPL_3: DISP1.P$27 (BP3), DISP1.P$28 (BP3), IC1.P$1 (BP2)
GND: C1.2, C2.2, C3.2, IC1.P$49 (OSC), IC1.P$54 (VSS), J1.1, JP1.3, JP2.3, JP3.3, JP4.3, R4.E, S1.1, S2.1, S3.1, S4.1
KEY1: J1.6, S1.3 (2)
KEY2: J1.7, S2.3 (2)
KEY3: J1.8, S3.3 (2)
KEY4: J1.9, S4.3 (2)
LED: J1.5, R3.1
unnamed: JP5.2, R1.1
unnamed: JP6.2, R2.1
unnamed: D1.K (C), R3.2
SA0: IC1.P$53 (SA0), JP4.2
SCL: IC1.P$45 (SCL), J1.4, JP6.1
SDA: IC1.P$44 (SDA), J1.3, JP5.1
SEG_0: DISP1.P$1 (SEG0), IC1.P$4 (S0)
SEG_1: DISP1.P$2 (SEG1), IC1.P$5 (S1)
SEG_2: DISP1.P$3 (SEG2), IC1.P$6 (S2)
SEG_3: DISP1.P$4 (SEG3), IC1.P$7 (S3)
SEG_4: DISP1.P$5 (SEG4), IC1.P$8 (S4)
SEG_5: DISP1.P$6 (SEG5), IC1.P$9 (S5)
SEG_6: DISP1.P$7 (SEG6), IC1.P$10 (S6)
SEG_7: DISP1.P$8 (SEG7), IC1.P$11 (S7)
SEG_8: DISP1.P$9 (SEG8), IC1.P$12 (S8)
SEG_9: DISP1.P$10 (SEG9), IC1.P$13 (S9)
SEG_10: DISP1.P$11 (SEG10), IC1.P$14 (S10)
SEG_11: DISP1.P$12 (SEG11), IC1.P$15 (S11)
SEG_12: DISP1.P$13 (SEG12), IC1.P$16 (S12)
SEG_13: DISP1.P$14 (SEG13), IC1.P$17 (S13)
SEG_14: DISP1.P$15 (SEG14), IC1.P$18 (S14)
SEG_15: DISP1.P$16 (SEG15), IC1.P$19 (S15)
SEG_16: DISP1.P$17 (SEG16), IC1.P$20 (S16)
SEG_17: DISP1.P$18 (SEG17), IC1.P$21 (S17)
SEG_18: DISP1.P$19 (SEG18), IC1.P$22 (S18)
SEG_19: DISP1.P$20 (SEG19), IC1.P$23 (S19)
SEG_20: DISP1.P$21 (SEG20), IC1.P$24 (S20)
SEG_21: DISP1.P$22 (SEG21), IC1.P$25 (S21)
SEG_22: DISP1.P$23 (SEG22), IC1.P$26 (S22)
SEG_23: DISP1.P$24 (SEG23), IC1.P$27 (S23)
VCC: C1.1, C3.1, D1.A, IC1.P$48 (VDD), J1.2, JP1.1, JP2.1, JP3.1, JP4.1, R1.2, R2.2, R4.A
VLCD: C2.1, IC1.P$55 (VLCD), J1.10, R4.S

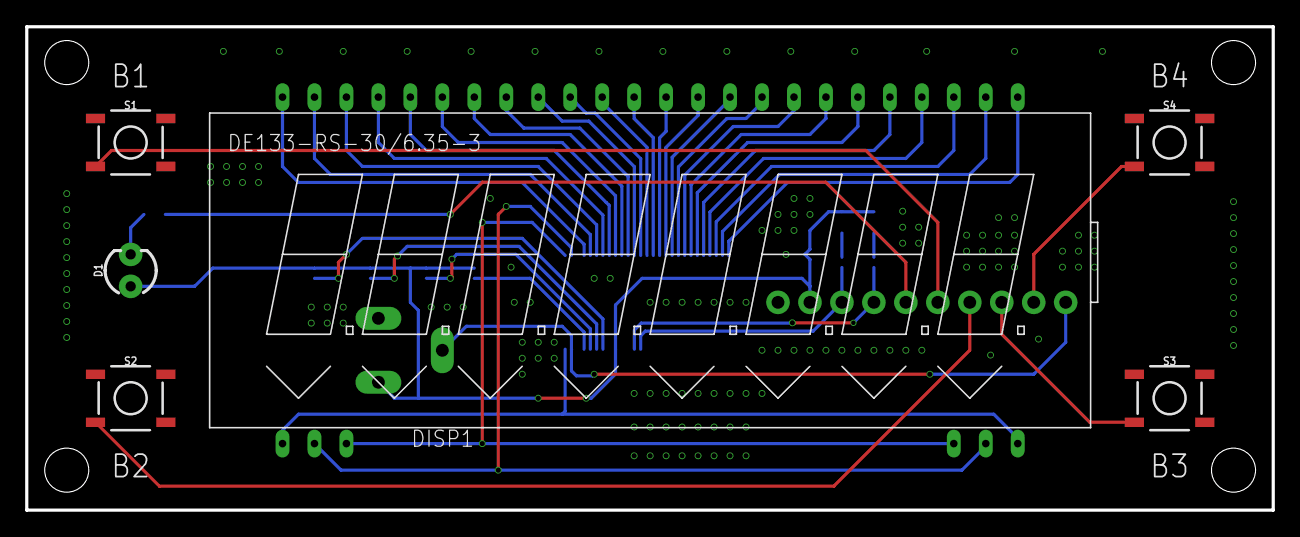
[picture p72: board LCD_Board.brd from above]

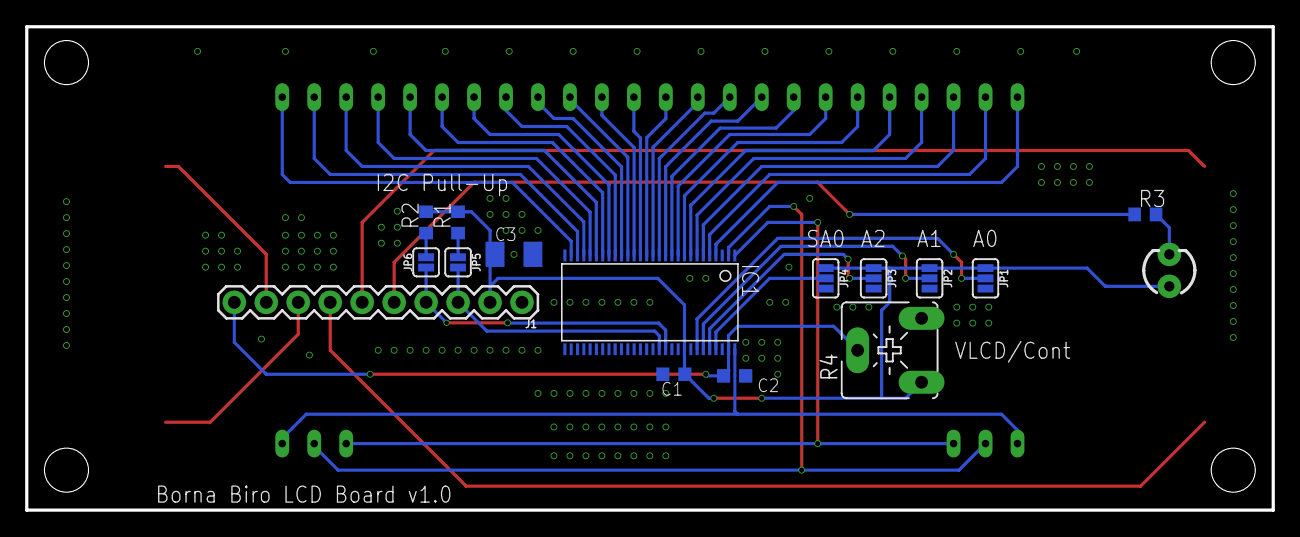
[picture p73: board LCD_Board.brd from below]

Board: 2 copper layers, 99.0 x 38.4 mm, 21 parts (15 on the bottom side), 44 nets.
