BornaBiro/ESP32_WeatherPaper/Outdoor Unit Files/STM32 Code/Diplomski_Outdoor_Unit/Diplomski_Outdoor_Unit.ioc

Mcu.UserName=STM32L073CZTx
PA0.Signal=ADC_IN0
PA1.Signal=ADC_IN1
PA10.GPIO_Label=WS_DIN
PA10.Signal=GPIO_Input
PA13.Signal=SYS_SWDIO
PA14.Signal=SYS_SWCLK
PA2.Signal=USART2_TX
PA3.Signal=USART2_RX
PA4.Signal=ADC_IN4
PA5.Signal=SPI1_SCK
PA6.Signal=SPI1_MISO
PA7.Signal=SPI1_MOSI
PA8.Signal=GPXTI8
PA9.GPIO_Label=BAT_M_EN
PA9.Signal=GPIO_Output
PB1.Signal=GPXTI1
PB11.GPIO_Label=EN_3V3SW
PB11.Signal=GPIO_Output
PB4.GPIO_Label=NRF24_CE
PB4.Signal=GPIO_Output
PB5.GPIO_Label=SI1147_INT
PB5.Signal=GPIO_Input
PB6.GPIO_Label=NRF24_CSN
PB6.Signal=GPIO_Output
PB8.Signal=I2C1_SCL
PB9.Signal=I2C1_SDA
PC14-OSC32_IN.Signal=RCC_OSC32_IN
PC15-OSC32_OUT.Signal=RCC_OSC32_OUT
PH0-OSC_IN.Signal=RCC_OSC_IN
PH1-OSC_OUT.Signal=RCC_OSC_OUT
