BornaBiro/ESP32_WeatherPaper/Indoor Unit Files/Arduino Code/Sketch/ESP32_WeatherPaper/ESP32_WeatherPaper.ino

// Includes for communication and periph.
#include <Wire.h>
#include <SPI.h>
#include "driver/rtc_io.h"
#include "timeAndDate.h"

// WiFi and Internet includes
#include <WiFi.h>
#include <esp_wifi.h>
#include <WiFiUdp.h>
#include "Weather.h"

// Display includes (driver, icons, fonts, etc)
#include <Inkplate.h>
#include "GUI.h"
#include "Neucha_Regular17pt7b.h"
#include "RobotoCondensed_Regular6pt7b.h"
#include "icons.h"
#include <TSC2046E_Inkplate.h>

// Sensor includes
#include <Adafruit_Sensor.h>
#include <Adafruit_BME280.h>
#include <Adafruit_SGP30.h>

// Other includes
#include "sys/time.h"
#include "structs.h"
#include <EEPROM.h>
#include "PCF85063.h"
#include "communication.h"
#include "RF24_Inkplate.h"

// SD Card Library
#include <SdFat.h>

//.ttf to .h: https://rop.nl/truetype2gfx/
//Open Source fonts https://fonts.google.com/
#define DISPLAY_FONT &Neucha_Regular17pt7b
#define DISPLAY_FONT_SMALL &RobotoCondensed_Regular6pt7b

#define NEW_INKPLATE

// Objects / constructors
Inkplate display(INKPLATE_1BIT);
TSC2046E_Inkplate ts;
SPIClass *mySpi = NULL;
Adafruit_BME280 bme;
OWMWeather owm;
GUI gui;
pcf85063 rtc;
communication rf;
RF24_Inkplate radio(14, 15, 2000000);
Adafruit_SGP30 sgp;

// Consts for hour, minutes, seconds, ...
struct tm tNow;
time_t timeToWake;
int timeOffset;

const char ssid[] = "Biro_WLAN_2";
//const char ssid[] = "BornaSGS20+5G";
const char pass[] = "CaVex250_H2sH11";
//const char pass[] = "tps65186PMIC";
//const char ssid[] = "Optima-322d0e";
//const char pass[] = "OPTIMA2649004925";

uint8_t modeSelect = 0;
uint8_t forcedRef = 0;
uint8_t selectedDay = 0;
uint8_t selectedGraph = 0;
uint8_t wifiCounter = 0;
uint32_t sdDataDayOffset = 0;
uint16_t sdDataOffset = 0;
time_t co2Timeout = 0;

struct sensorData sensor;
struct currentWeatherHandle currentWeather;
struct forecastListHandle forecastList;
struct forecastDisplayHandle forecastDisplay[7];
struct oneCallApiHandle oneCallApi;
struct syncStructHandle syncStruct;
struct measruementHandle outdoorData;

void setup()
{
  // Varibles for storing status of each module while init
  uint8_t sdError = 0;
  uint8_t bmeError = 0;
  uint8_t radioError = 0;

  // Init System libraries
  Serial.begin(115200);
  Wire.begin();
  display.begin();
  EEPROM.begin(64);

  // Set output mode of MCP INT pin
  display.setIntOutputInternal(MCP23017_INT_ADDR, display.mcpRegsInt, 1, 0, 0, 1);

  // Set touchscreen controller INT pin
  display.pinModeInternal(MCP23017_INT_ADDR, display.mcpRegsInt, 13, INPUT_PULLUP);
  display.setIntPinInternal(MCP23017_INT_ADDR, display.mcpRegsInt, 13, FALLING);

  // Set default pin state on touchscreen controller CS pin
  display.pinModeInternal(MCP23017_INT_ADDR, display.mcpRegsInt, 10, OUTPUT);
  display.digitalWriteInternal(MCP23017_INT_ADDR, display.mcpRegsInt, 10, HIGH);

  // Set default state of nRF24l01 pins
  display.digitalWriteInternal(MCP23017_INT_ADDR, display.mcpRegsInt, 14, HIGH);
  display.digitalWriteInternal(MCP23017_INT_ADDR, display.mcpRegsInt, 15, HIGH);

  // Set RTC INT PIN
  display.pinModeInternal(MCP23017_INT_ADDR, display.mcpRegsInt, 12, INPUT_PULLUP);
  display.setIntPinInternal(MCP23017_INT_ADDR, display.mcpRegsInt, 12, FALLING);

  // Set 3V3SW pin as output
  display.pinModeInternal(MCP23017_INT_ADDR, display.mcpRegsInt, 11, OUTPUT);
  display.digitalWriteInternal(MCP23017_INT_ADDR, display.mcpRegsInt, 11, LOW);

  // Clear all INT flags on MCP
  display.getINTstateInternal(MCP23017_INT_ADDR, display.mcpRegsInt);

  // Init GUI communication and RTC library
  gui.init(&display);
  rf.init(&radio, &display, &rtc);
  rtc.RTCinit();

  // Get the SPI object from Inkplate library
  mySpi = display.getSPIptr();
  mySpi->begin(14, 12, 13, 15);

  // Init touchscreen controller
  ts.begin(mySpi, &display, 10, 13);
  ts.calibrate(800, 3420, 3553, 317, 0, 799, 0, 599);

  // Init all the modules
  radioError = radio.begin(mySpi, &display);
  bmeError = bme.begin(0x76);
  sdError = display.sdCardInit();

  display.setTextWrap(false);
  display.setFont(DISPLAY_FONT);
  display.setTextColor(BLACK, WHITE);
  display.setCursor(0, 24);

  // Show is there any error with init of sensors
  if (!(sdError && bmeError && radioError))
  {
    display.print("Pogreška s ");
    if (!sdError)
    {
      display.print("SD karticom");
      display.setCursor(0, display.getCursorY() + 24);
    }
    if (!bmeError)
    {
      display.print("senzorom temp., vlage i tlaka");
      display.setCursor(0, display.getCursorY() + 24);
    }
    if (!radioError)
    {
      display.print("radijskim modulom");
      display.setCursor(0, display.getCursorY() + 24);
    }
    display.print("Provjerite modul i ponovno pokrenite uredjaj!");
    display.display();
    esp_deep_sleep_start();
    while (1);
  }

  // Change WiFi name
  WiFi.mode(WIFI_STA);
  WiFi.disconnect();
  WiFi.setHostname("WeatherPaper");
  WiFi.config(IPAddress(192, 168, 1, 10), IPAddress(192, 168, 1, 1), IPAddress(255, 255, 255, 0), IPAddress(192, 168, 1, 1), IPAddress(8, 8, 4, 4));

  // Setup a temperatue, humidity and pressure sensor
  bme.setSampling(Adafruit_BME280::MODE_FORCED,
                  Adafruit_BME280::SAMPLING_X16, // temperature
                  Adafruit_BME280::SAMPLING_X16, // pressure
                  Adafruit_BME280::SAMPLING_X16, // humidity
                  Adafruit_BME280::FILTER_X16   );

  // Try to connect to WiFi
  uint8_t wiFiRetry = 30;
  int n = WiFi.scanNetworks();
  if (n > 6) n = 6;
  display.clearDisplay();
  display.setCursor(0, 24);
  display.println("ESP32 WeatherPaper\nTrazenje WiFi Mreza...");
  display.display();
  for (int i = 0; i < n; i++)
  {
    display.setCursor(70, 100 + (i * 35));
    display.print(WiFi.SSID(i));
    display.print((WiFi.encryptionType(i) == WIFI_AUTH_OPEN) ? ' ' : '*');
    display.print(' ');
    display.print(WiFi.RSSI(i), DEC);
  }
  display.partialUpdate(false, true);
  display.setCursor(70, 550);
  display.print(F("Spajanje na "));
  display.print(ssid);
  display.partialUpdate(false, true);
  WiFi.begin(ssid, pass);
  powerUpCO2sensor(&co2Timeout);
  while (WiFi.status() != WL_CONNECTED && wiFiRetry > 0)
  {
    delay(1000);
    display.print('.');
    display.partialUpdate(false, true);
    wiFiRetry--;
  }
  if(WiFi.status() == WL_CONNECTED)
  {
    display.print("spojeno! Pricekajte...");
    display.partialUpdate(false, true);
  }
  else
  {
    display.print("Spajanje neuspjesno!");
    display.display();
    readCO2sensor(&co2Timeout);
    esp_deep_sleep_start();
    while (1);
  }

  // Read data from sensors and from the Internet
  readCO2sensor(&co2Timeout);

  readSensor(&sensor);
  updateWeatherData();

  // Check if the time is set and if it not set it by connecting to NTP serer
  // After that try to sync with outdoor unit and set new wakeup time and save it in EEPROM
  time_t myTime;
  if (!rtc.isClockSet() && readNTP(&myTime))
  {
    rtc.setClock(myTime);
    radio.powerUp();
    rf.setupCommunication();
    if (rf.sync(&syncStruct))
    {
      display.clearDisplay();
      display.print("Sinkronizacija uspjesna!");
      display.display();
      timeToWake = (time_t)syncStruct.sendEpoch;
      rtc.setAlarm(timeToWake);
      EEPROM.put(0, timeToWake);
      EEPROM.commit();
    }
    else
    {
      // If sync failed, make a new wakeup time, just in case and save it to EEPROM
      display.clearDisplay();
      display.print("Sinkronizacija nije uspjela");
      display.display();
      timeToWake = rf.newWakeupTime(rtc.getClock());
      //rtc.setAlarm(timeToWake);
      EEPROM.put(0, timeToWake);
      EEPROM.commit();
    }
  }
  // Check if the time to wake has already passed. If it is, calculate new wakeup time
  EEPROM.get(0, timeToWake);
  if ((rtc.getClock() >= timeToWake) || (abs(timeToWake - rtc.getClock()) > (60 * WAKEUP_INTERVAL)))
  {
    timeToWake = rf.newWakeupTime(rtc.getClock());
    //rtc.setAlarm(timeToWake);
    EEPROM.put(0, timeToWake);
    EEPROM.commit();
  }
  
  // Read the battery (TPS and nRF messes up battery readings)
  sensor.battery = ts.getBatteryVoltage();
  tNow = epochToHuman(rtc.getClock());
  gui.drawMainScreen(&sensor, &currentWeather, &forecastList, forecastDisplay, &oneCallApi, &outdoorData, &tNow);

  esp_wifi_stop();
  btStop();

  rtc.setAlarm(timeToWake);
}

void loop()
{
  int tsX, tsY;
  rtc_gpio_isolate(GPIO_NUM_12);
  // Make ESP32 GPIO34 INT pin that wakes up ESP32
  esp_sleep_enable_ext0_wakeup(GPIO_NUM_34, 1);
  esp_light_sleep_start();

  // If ESP32 has woken up, see what caused wake up and clear the INT flags in MCP23017
  uint16_t intPins = display.getINTInternal(MCP23017_INT_ADDR, display.mcpRegsInt);
  display.getINTstateInternal(MCP23017_INT_ADDR, display.mcpRegsInt);

  // If the touchscreen woke ESP32 up, get the X and Y of touch and check what has been pressed
  if ((intPins & (1 << 13)) && ts.available(&tsX, &tsY))
  {
    switch (modeSelect)
    {
      case 0:
        // Touched one of weather forecast days
        if (touchArea(tsX, tsY, 0, 410, 800, 190))
        {
          selectedDay = tsX / 160;
          drawDays(selectedDay, true);
          modeSelect = 1;
        }

        // NTP Sync button
        if (touchArea(tsX, tsY, 660, 5, 40, 40))
        {
          time_t _myNewTime;
          time_t _myNewAlarmTime;
          uint8_t _wiFiRetry = 0;
          writeInfoBox(350, "Sinkronizacija sata...");
          display.partialUpdate(false, true);
          esp_wifi_start();
          WiFi.mode(WIFI_STA);
          WiFi.begin(ssid, pass);
          while (WiFi.status() != WL_CONNECTED && _wiFiRetry < 15)
          {
            delay(1000);
            _wiFiRetry++;
          }
          if(WiFi.status() == WL_CONNECTED)
          {
            if (readNTP(&_myNewTime))
            {
              writeInfoBox(350, "Sinkronizacija sata ok!");
              display.partialUpdate(false, true);
              rtc.setClock(_myNewTime);
              _myNewAlarmTime = rf.newWakeupTime(_myNewTime);
              rtc.setAlarm(_myNewAlarmTime);
              EEPROM.put(0, _myNewAlarmTime);
              EEPROM.commit();
              delay(1000);
            }
          }
          esp_wifi_stop();
          btStop();
          gui.drawMainScreen(&sensor, &currentWeather, &forecastList, forecastDisplay, &oneCallApi, &outdoorData, &tNow);
        }

        // Outdoor unit sync
        if (touchArea(tsX, tsY, 710, 5, 40, 40))
        {
          radio.powerUp();
          rf.setupCommunication();
          uint8_t _myNewSync = rf.sync(&syncStruct);
          if (_myNewSync)
          {
            rtc.setAlarm(syncStruct.sendEpoch);
            EEPROM.put(0, (time_t)syncStruct.sendEpoch);
            EEPROM.commit();
          }
          gui.drawMainScreen(&sensor, &currentWeather, &forecastList, forecastDisplay, &oneCallApi, &outdoorData, &tNow);
        }

        // Forced data refresh button
        if (touchArea(tsX, tsY, 760, 0, 40, 50))
        {
          display.setFont(DISPLAY_FONT);
          display.setCursor(610, 35);
          writeInfoBox(350, "Osvjez. podataka, pricekajte");
          display.partialUpdate(false, true);
          forcedRef = 1;
        }

        // If it's pressed, show outdoor unit data by today
        if (touchArea(tsX, tsY, 534, 60, 267, 290))
        {
          modeSelect = 2;
          gui.drawOutdoorData(&rf, rtc.getClock(), 0, &sdDataOffset, selectedGraph, 1);
          display.display();
        }

        // If it's pressed, show indoor unit data starting by today
        if (touchArea(tsX, tsY, 267, 60, 267, 290))
        {
          modeSelect = 3;
          gui.drawIndoorData(&rf, rtc.getClock(), 0, &sdDataOffset, selectedGraph, 1);
          display.display();
        }
        break;

      // Weather forecast
      case 1:
        if (touchArea(tsX, tsY, 10, 570, 30, 30))
        {
          gui.drawMainScreen(&sensor, &currentWeather, &forecastList, forecastDisplay, &oneCallApi, &outdoorData, &tNow);
          modeSelect = 0;
          selectedDay = 0;
          selectedGraph = 0;
          sdDataDayOffset = 0;
        }

        // Go one day back (if it's possible)
        if (touchArea(tsX, tsY, 0, 0, 75, 75) && selectedDay > 0)
        {
          selectedDay--;
          drawDays(selectedDay, false);
          modeSelect = 1;
        }

        // Go one day FW (if it's possible)
        if (touchArea(tsX, tsY, 730, 0, 70, 50) && selectedDay < 4)
        {
          selectedDay++;
          drawDays(selectedDay, false);
          modeSelect = 1;
        }

        // Show graph for selected data
        if (touchArea(tsX, tsY, 50, 550, 700, 150))
        {

          selectedGraph = (tsX - 50) / 70;
          drawSelectedGraph(selectedGraph, selectedDay);
          display.partialUpdate(false, true);
        }

        // Show pop-up "window" with data of selected day and time
        if (touchArea(tsX, tsY, 0, 70, 800, 70))
        {
          int selectedElement = tsX / 100;
          int _yPos = 240;
          const int _fontScale = 2;
          const int _fontYSize = 14 * _fontScale;
          if (selectedElement < (forecastList.startElement[selectedDay + 2 - forecastList.shiftDay] - forecastList.startElement[selectedDay + 1 - forecastList.shiftDay]))
          {
            int element = forecastList.startElement[selectedDay + 1 - forecastList.shiftDay] + selectedElement;
            display.fillRect(198, 198, 404, 304, BLACK);
            display.fillRect(200, 200, 400, 300, WHITE);
            display.setFont(DISPLAY_FONT_SMALL);
            display.setTextSize(_fontScale);
            display.setCursor(220, _yPos);  _yPos += _fontYSize;
            display.print(forecastList.forecast[element].weatherDesc);
            display.setCursor(220, _yPos);  _yPos += _fontYSize;
            display.print("Temp.: ");
            display.print(forecastList.forecast[element].minTemp, 1);
            display.print("[Min] / ");
            display.print(forecastList.forecast[element].temp, 1);
            display.print(" / ");
            display.print(forecastList.forecast[element].maxTemp, 1);
            display.print("[Max] C");

            display.setCursor(220, _yPos);  _yPos += _fontYSize;
            display.print("Tlak zraka: ");
            display.print(forecastList.forecast[element].pressureGnd);
            display.print("hPa");

            display.setCursor(220, _yPos);  _yPos += _fontYSize;
            display.print("Brzina vjetra: ");
            display.print(forecastList.forecast[element].windSpeed, 1);
            display.print('/');
            display.print(forecastList.forecast[element].windGust, 1);
            display.print("m/s");

            display.setCursor(220, _yPos);  _yPos += _fontYSize;
            display.print("Smjer vjetra: ");
            display.print(oznakeVjetar[int((forecastList.forecast[element].windDir / 22.5) + .5) % 16]);
            display.print('[');
            display.print(forecastList.forecast[element].windDir);
            display.print(" st.]");

            display.setCursor(220, _yPos);  _yPos += _fontYSize;
            display.print("Naoblaka: ");
            display.print(forecastList.forecast[element].clouds);
            display.print('%');

            display.setCursor(220, _yPos);  _yPos += _fontYSize;
            display.print("Snijeg: ");
            display.print(forecastList.forecast[element].snow, 1);
            display.print("mm");

            display.setCursor(220, _yPos);  _yPos += _fontYSize;
            display.print("Kisa: ");
            display.print(forecastList.forecast[element].rain, 1);
            display.print("mm");
          }
          display.setTextSize(1);
          display.partialUpdate(false, true);
        }
        break;

        // Indoor and outdoor graphs
        case 2:
        case 3:
          // Move one day back
          if (touchArea(tsX, tsY, 0, 0, 75, 75))
          {
            sdDataDayOffset++;
            sdDataOffset = 0;
            if (modeSelect == 2) gui.drawOutdoorData(&rf, rtc.getClock(), sdDataDayOffset, &sdDataOffset, selectedGraph);
            if (modeSelect == 3) gui.drawIndoorData(&rf, rtc.getClock(), sdDataDayOffset, &sdDataOffset, selectedGraph);
            display.partialUpdate(false, true);
          }
          
          // Move one day FW
          if (touchArea(tsX, tsY, 730, 0, 70, 50) && sdDataDayOffset != 0)
          {
            sdDataDayOffset--;
            sdDataOffset = 0;
            if (modeSelect == 2) gui.drawOutdoorData(&rf, rtc.getClock(), sdDataDayOffset, &sdDataOffset, selectedGraph);
            if (modeSelect == 3) gui.drawIndoorData(&rf, rtc.getClock(), sdDataDayOffset, &sdDataOffset, selectedGraph);
            display.partialUpdate(false, true);
          }

          // Get back to main screen
          if (touchArea(tsX, tsY, 10, 570, 30, 30))
          {
            sdDataDayOffset = 0;
            modeSelect = 0;
            sdDataOffset = 0;
            selectedGraph = 0;
            gui.drawMainScreen(&sensor, &currentWeather, &forecastList, forecastDisplay, &oneCallApi, &outdoorData, &tNow);
          }

          // Move one dataset FW
          if (touchArea(tsX, tsY, 90, 140, 30, 30))
          {
            if (sdDataOffset != 0) sdDataOffset--;
            if (modeSelect == 2) gui.drawOutdoorData(&rf, rtc.getClock(), sdDataDayOffset, &sdDataOffset, selectedGraph);
            if (modeSelect == 3) gui.drawIndoorData(&rf, rtc.getClock(), sdDataDayOffset, &sdDataOffset, selectedGraph);
            display.partialUpdate(false, true);
          }

          // Move one dataset back
          if (touchArea(tsX, tsY, 680, 140, 30, 30))
          {
            sdDataOffset++;
            if (modeSelect == 2) gui.drawOutdoorData(&rf, rtc.getClock(), sdDataDayOffset, &sdDataOffset, selectedGraph);
            if (modeSelect == 3) gui.drawIndoorData(&rf, rtc.getClock(), sdDataDayOffset, &sdDataOffset, selectedGraph);
            display.partialUpdate(false, true);
          }

          // Go back to the first measurement in day
          if (touchArea(tsX, tsY, 40, 140, 30, 30))
          {
            sdDataOffset = 0;
            if (modeSelect == 2) gui.drawOutdoorData(&rf, rtc.getClock(), sdDataDayOffset, &sdDataOffset, selectedGraph);
            if (modeSelect == 3) gui.drawIndoorData(&rf, rtc.getClock(), sdDataDayOffset, &sdDataOffset, selectedGraph);
            display.partialUpdate(false, true);
          }

          // Go back to the last measurement in day
          if (touchArea(tsX, tsY, 730, 140, 30, 30))
          {
            sdDataOffset = 0;
            if (modeSelect == 2) gui.drawOutdoorData(&rf, rtc.getClock(), sdDataDayOffset, &sdDataOffset, selectedGraph, 1);
            if (modeSelect == 3) gui.drawIndoorData(&rf, rtc.getClock(), sdDataDayOffset, &sdDataOffset, selectedGraph, 1);
            display.partialUpdate(false, true);
          }

          if (touchArea(tsX, tsY, 50, 550, 750, 150) && modeSelect == 2)
          {
            selectedGraph = (tsX - 50) / 70;
            gui.drawOutdoorData(&rf, rtc.getClock(), sdDataDayOffset, &sdDataOffset, selectedGraph);
            display.partialUpdate(false, true);
          }

          if(touchArea(tsX, tsY, 50, 490, 750, 150) && modeSelect == 3)
          {
            selectedGraph = (tsX - 50) / 70;
            gui.drawIndoorData(&rf, rtc.getClock(), sdDataDayOffset, &sdDataOffset, selectedGraph);
            display.partialUpdate(false, true);
          }
          break;
    }
  }

  if ((rtc.checkAlarmFlag() && (intPins & (1 << 12))) || forcedRef)
  {
    uint8_t _rxOk = 0;

    // Read the battery (TPS and nRF messes up battery readings)
    sensor.battery = ts.getBatteryVoltage();

    display.setFont(DISPLAY_FONT_SMALL);
    display.setTextSize(1);
    display.setCursor(5, 46);
    display.print("Dohvacanje podataka...");
    display.partialUpdate(false, false);

    // If it's not the user forced update of data, that means is RTC and it's time to get the data from outdook unit
    if (!forcedRef)
    {
      wifiCounter++;
      rtc.clearAlarm();
      _rxOk = rf.getData(&syncStruct, &outdoorData);
      timeToWake = (time_t)syncStruct.sendEpoch;
      rtc.setAlarm(timeToWake);
      EEPROM.put(0, timeToWake);
      EEPROM.commit();
    }

    // Get new weather data from the internet and new CO2 readings every 30 minutes
    if (wifiCounter > 5 || forcedRef)
    {
      wifiCounter = 0;

      powerUpCO2sensor(&co2Timeout);

      esp_wifi_start();
      WiFi.mode(WIFI_STA);
      WiFi.begin(ssid, pass);
      int i = 0;
      while (WiFi.status() != WL_CONNECTED && (i < 15))
      {
        delay(1000);
        display.print('.');
        display.partialUpdate(false, true);
        i++;
      }
      display.einkOff();
      if (WiFi.status() == WL_CONNECTED) updateWeatherData();
      esp_wifi_stop();
      btStop();

      readCO2sensor(&co2Timeout);
    }

  	readSensor(&sensor);
    if (!forcedRef) rf.saveDataToSD(&sensor, _rxOk?&outdoorData:NULL);
    modeSelect = 0;
    selectedDay = 0;
    selectedGraph = 0;
    sdDataDayOffset = 0;
    sdDataOffset = 0;
    tNow = epochToHuman(rtc.getClock());
    gui.drawMainScreen(&sensor, &currentWeather, &forecastList, forecastDisplay, &oneCallApi, &outdoorData, &tNow);
    forcedRef = 0;
  }
}

void writeInfoBox(int y, char *c)
{
  int16_t  x1, y1;
  uint16_t w, h;
  int x;
  display.setTextSize(2);
  display.getTextBounds(c, 0, y, &x1, &y1, &w, &h);
  x = (800 - w) / 2;
  display.getTextBounds(c, x, y, &x1, &y1, &w, &h);
  display.fillRect(x1 - 3, y1 - 3, w + 6, h + 6, WHITE);
  display.drawRect(x1 - 2, y1 - 2, w + 4, h + 4, BLACK);
  display.drawRect(x1 - 1, y1 - 1, w + 2, h + 2, BLACK);
  display.setCursor(x, y);
  display.print(c);
  display.setTextSize(1);
} 

void readSensor(struct sensorData *_s)
{
  _s->epoch = (time_t)rtc.getClock();
  bme.takeForcedMeasurement();
  _s->temp = bme.readTemperature();
  _s->humidity = bme.readHumidity();
  _s->pressure = bme.readPressure() / 100.0F;
  _s->eco2 = sgp.eCO2;
  _s->tvoc = sgp.TVOC;
  _s->rawH2 = sgp.rawH2;
  _s->rawEthanol = sgp.rawEthanol;
}

bool readNTP(time_t *_epoch)
{
  IPAddress ntpIp;
  WiFiUDP udp;
  const char* NTPServer = "hr.pool.ntp.org";
  uint16_t ntpPort = 123;
  uint8_t ntpPacket[48];
  unsigned long _ntpTimeout;

  udp.begin(8888);
  if (!WiFi.hostByName(NTPServer, ntpIp)) return 0;

  ntpPacket[0] = B11100011; //Clock is unsync, NTP version 4, Symmetric passive
  ntpPacket[1] = 0;     // Stratum, or type of clock
  ntpPacket[2] = 60;     // Polling Interval
  ntpPacket[3] = 0xEC;  // Peer Clock Precision
  // 8 bytes of zero for Root Delay & Root Dispersion
  ntpPacket[12]  = 49;
  ntpPacket[13]  = 0x4E;
  ntpPacket[14]  = 49;
  ntpPacket[15]  = 52;
  udp.beginPacket(ntpIp, 123);
  udp.write(ntpPacket, 48);
  udp.endPacket();
  _ntpTimeout = millis();
  while ((unsigned long)(millis() - _ntpTimeout) < 5000)
  {
    if (udp.parsePacket() >= 48)
    {
      udp.read(ntpPacket, 48);
      int32_t unix = ntpPacket[40] << 24 | ntpPacket[41] << 16 | ntpPacket[42] << 8 | ntpPacket[43];
      *_epoch = unix - 2208988800UL + currentWeather.timezone;
      return true;
    }
  }
  return false;
}

void updateWeatherData()
{
  owm.getCurrentWeather("http://api.openweathermap.org/data/2.5/weather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", &currentWeather);
  owm.getForecastWeather("http://api.openweathermap.org/data/2.5/forecast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", &forecastList, forecastDisplay);
  owm.oneCall("http://api.openweathermap.org/data/2.5/onecall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,minutely,hourly,daily&appid=b1d3e9077193732d4b5e3e2c4c036657", &oneCallApi);  //Upozorenja
  //owm.oneCall("http://api.openweathermap.org/data/2.5/onecall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,minutely,hourly,daily&appid=b1d3e9077193732d4b5e3e2c4c036657", &oneCallApi);
}

void changeLetters(char *p)
{
  int webTextSize = strlen(p);
  for (int16_t i = 0; i < webTextSize; i++)
  {
    if (p[i] == 196 || p[i] == 197) memmove(&p[i], &p[i + 1], webTextSize - i);
    if (p[i] == 141 || p[i] == 135) p[i] = 'c';
    if (p[i] == 161) p[i] = 's';
    if (p[i] == 190) p[i] = 'z';
  }
}

void drawDays(uint8_t n, bool fullUpdate)
{
  display.clearDisplay();
  display.setFont(DISPLAY_FONT_SMALL);
  display.setTextSize(2);
  uint8_t xPos = 0;
  uint8_t start = forecastList.startElement[-forecastList.shiftDay + n + 1];
  uint8_t end = forecastList.startElement[-forecastList.shiftDay + n + 2];
  for (int i = start; i < end; i++)
  {
    display.drawBitmap(xPos * 95 + 45, 70, gui.weatherIcon(atoi(forecastList.forecast[i].weatherIcon)), 50, 50, BLACK);
    display.setCursor(xPos * 95 + 30, 140);
    display.print(epochToHuman(forecastList.forecast[i].timestamp).tm_hour, DEC);
    display.print(":00h");
    xPos++;
  }
  display.setTextSize(1);
  if (n > 0) display.fillTriangle(50, 10, 50, 40, 20, 25, BLACK);
  if (n < 4) display.fillTriangle(750, 10, 750, 40, 780, 25, BLACK);
  display.fillTriangle(10, 580, 30, 570, 30, 590, BLACK);

  display.setFont(DISPLAY_FONT);
  display.fillRect(4, 50, 792, 3, BLACK);
  display.setCursor(200, 35);
  display.print("Vremenska prognoza za ");
  display.print(epochToHuman(forecastList.forecast[start].timestamp).tm_mday, DEC);
  display.print('.');
  display.print(epochToHuman(forecastList.forecast[start].timestamp).tm_mon + 1, DEC);
  display.print(".,");
  display.print(DOW[epochToHuman(forecastList.forecast[start].timestamp).tm_wday]);

  for (int i = 0; i < 10; i++)
  {
    const uint8_t *iconList[] = {iconTemp, iconTlak, iconVlaga, iconVjetar, iconWindDir, iconClouds, iconVisability, iconRainDrop, iconSnowflake, iconProbability};
    display.drawBitmap((i * 70) + 50, 550, iconList[i], 40, 40, BLACK);
  }
  drawSelectedGraph(selectedGraph, n);

  if (fullUpdate)
  {
    display.display();
  }
  else
  {
    display.partialUpdate(false, true);
  }
}

void drawSelectedGraph(uint8_t _graph, uint8_t _day)
{
  uint8_t start = forecastList.startElement[-forecastList.shiftDay + _day + 1];
  uint8_t end = forecastList.startElement[-forecastList.shiftDay + _day + 2];
  uint8_t _n = end - start;
  display.fillRect(4, 540, 792, 3, BLACK);
  display.fillRect((selectedGraph * 70) + 35, 540, 70, 3, WHITE);
  display.setFont(NULL);
  display.setTextSize(2);
  display.fillRect(0, 170, 800, 360, WHITE);
  switch (_graph)
  {
    case 0:
      gui.printAlignText("Temperatura zraka [C]", 400, 195, ALIGMENT_CENTERBOT);
      gui.drawGraph(130, 200, 600, 300, &(forecastList.forecast[start].timestamp), &(forecastList.forecast[start].temp), _n, sizeof(struct forecastWeatherHandle), 12, DATATYPE_FLOAT, GRAPHSTYLE_LINE);
      break;
    case 1:
      gui.printAlignText("Tlak zraka [hPa]", 400, 195, ALIGMENT_CENTERBOT);
      gui.drawGraph(130, 200, 600, 300, &(forecastList.forecast[start].timestamp), &(forecastList.forecast[start].pressureGnd), _n, sizeof(struct forecastWeatherHandle), 12, DATATYPE_UINT16_T, GRAPHSTYLE_LINE);
      break;
    case 2:
      gui.printAlignText("Relat. vlaznost zraka [%]", 400, 195, ALIGMENT_CENTERBOT);
      gui.drawGraph(130, 200, 600, 300, &(forecastList.forecast[start].timestamp), &(forecastList.forecast[start].humidity), _n, sizeof(struct forecastWeatherHandle), 10, DATATYPE_UINT8_T, GRAPHSTYLE_LINE, 0, 100);
      break;
    case 3:
      gui.printAlignText("Brzina vjetra [m/s]", 400, 195, ALIGMENT_CENTERBOT);
      gui.drawGraph(130, 200, 600, 300, &(forecastList.forecast[start].timestamp), &(forecastList.forecast[start].windSpeed), _n, sizeof(struct forecastWeatherHandle), 12, DATATYPE_FLOAT, GRAPHSTYLE_LINE, 0);
      break;
    case 4:
      gui.printAlignText("Smjer vjetra [stupnjevi]", 400, 195, ALIGMENT_CENTERBOT);
      gui.drawGraph(130, 200, 600, 300, &(forecastList.forecast[start].timestamp), &(forecastList.forecast[start].windDir), _n, sizeof(struct forecastWeatherHandle), 12, DATATYPE_UINT16_T, GRAPHSTYLE_DOT, 0, 360);
      break;
    case 5:
      gui.printAlignText("Kolicina naoblake [%]", 400, 195, ALIGMENT_CENTERBOT);
      gui.drawGraph(130, 200, 600, 300, &(forecastList.forecast[start].timestamp), &(forecastList.forecast[start].clouds), _n, sizeof(struct forecastWeatherHandle), 10, DATATYPE_UINT8_T, GRAPHSTYLE_COLUMN, 0, 100);
      break;
    case 6:
      gui.printAlignText("Vidljivost [m]", 400, 195, ALIGMENT_CENTERBOT);
      gui.drawGraph(130, 200, 600, 300, &(forecastList.forecast[start].timestamp), &(forecastList.forecast[start].visibility), _n, sizeof(struct forecastWeatherHandle), 12, DATATYPE_UINT16_T, GRAPHSTYLE_LINE);
      break;
    case 7:
      gui.printAlignText("Kolicina padalina [mm]", 400, 195, ALIGMENT_CENTERBOT);
      gui.drawGraph(130, 200, 600, 300, &(forecastList.forecast[start].timestamp), &(forecastList.forecast[start].rain), _n, sizeof(struct forecastWeatherHandle), 12, DATATYPE_FLOAT, GRAPHSTYLE_COLUMN, 0);
      break;
    case 8:
      gui.printAlignText("Kolicina snijega [mm]" , 400, 195, ALIGMENT_CENTERBOT);
      gui.drawGraph(130, 200, 600, 300, &(forecastList.forecast[start].timestamp), &(forecastList.forecast[start].snow), _n, sizeof(struct forecastWeatherHandle), 12, DATATYPE_FLOAT, GRAPHSTYLE_COLUMN, 0);
      break;
    case 9:
      gui.printAlignText("Vjerojatnost oborina [%]", 400, 195, ALIGMENT_CENTERBOT);
      gui.drawGraph(130, 200, 600, 300, &(forecastList.forecast[start].timestamp), &(forecastList.forecast[start].probability), _n, sizeof(struct forecastWeatherHandle), 10, DATATYPE_UINT8_T, GRAPHSTYLE_COLUMN, 0, 100);
      break;
  }
}

uint8_t touchArea(int16_t tsX, int16_t tsY, int16_t x, int16_t y, int16_t w, int16_t h)
{
  if ((tsX >= x) && (tsY >= y) && (tsX < (x + w)) && (tsY < (y + h))) return 1;
  return 0;
}

void powerUpCO2sensor(time_t *_sgpTimeout)
{
  *_sgpTimeout = rtc.getClock() + 16;
  uint16_t eco2Base, tvocBase;
  // Power up and init C02 sensor
  display.digitalWriteInternal(MCP23017_INT_ADDR, display.mcpRegsInt, 11, HIGH);
  delay(10);
  sgp.begin();
  EEPROM.get(8, eco2Base);
  EEPROM.get(10, tvocBase);
  sgp.setIAQBaseline(eco2Base, tvocBase);
}

void readCO2sensor(time_t *_sgpTimeout)
{
  // CO2 sensor must work at leasts 15 seconds in order to get any data
  while(rtc.getClock() < (*_sgpTimeout))
  {
    delay(1000);
  }
  sgp.IAQmeasure();
  sgp.IAQmeasureRaw();
  // Power down sensor
  display.digitalWriteInternal(MCP23017_INT_ADDR, display.mcpRegsInt, 11, LOW);
}
