BornaBiro/ESP32_WeatherPaper/Indoor Unit Files/Arduino Code/Sketch/ESP32_WeatherPaper/RobotoCondensed_Regular6pt7b.h

#ifndef __ROBOTOCONDENSED_REGULAR6PT7B_H__
#define __ROBOTOCONDENSED_REGULAR6PT7B_H__

const uint8_t RobotoCondensed_Regular6pt7bBitmaps[] PROGMEM = {
  0x00, 0xFE, 0x80, 0xFC, 0x2A, 0xBE, 0xA5, 0x7D, 0x4C, 0xA0, 0x27, 0x99,
  0x86, 0x19, 0x9F, 0x40, 0xC2, 0xAB, 0x34, 0x20, 0xF5, 0x55, 0x1C, 0x63,
  0x49, 0x18, 0x62, 0xA9, 0xA6, 0x7C, 0xE0, 0x4D, 0x49, 0x24, 0x91, 0x22,
  0x89, 0x12, 0x49, 0x25, 0x28, 0x25, 0x5C, 0xA5, 0x00, 0x31, 0xBE, 0x63,
  0x18, 0x58, 0xE0, 0x80, 0x11, 0x22, 0x24, 0x44, 0x48, 0x69, 0x99, 0x99,
  0x99, 0x60, 0x74, 0x92, 0x49, 0x20, 0xE9, 0x91, 0x22, 0x48, 0xF0, 0x69,
  0x11, 0x61, 0x19, 0xE0, 0x18, 0x62, 0x8A, 0x49, 0x2F, 0xC2, 0x08, 0xF8,
  0x8F, 0x91, 0x19, 0x70, 0x6C, 0x8F, 0x99, 0x99, 0x60, 0xF8, 0x42, 0x21,
  0x08, 0x84, 0x60, 0x69, 0x99, 0x69, 0x99, 0x60, 0x69, 0x99, 0x9F, 0x13,
  0x60, 0x84, 0x40, 0x16, 0x13, 0xC3, 0x10, 0xF0, 0xF0, 0x86, 0x16, 0x80,
  0x72, 0xA6, 0x23, 0x10, 0x80, 0x20, 0x1E, 0x10, 0x93, 0x4A, 0xA9, 0x4C,
  0xAA, 0x54, 0xBE, 0x40, 0x30, 0x0F, 0x00, 0x10, 0x20, 0xA1, 0x42, 0x88,
  0x9F, 0x22, 0xC6, 0xF4, 0xE3, 0x2F, 0x46, 0x31, 0xF0, 0x76, 0x63, 0x08,
  0x42, 0x39, 0x70, 0xF4, 0xE3, 0x18, 0xC6, 0x33, 0xF0, 0xF4, 0x21, 0x0F,
  0x42, 0x10, 0xF8, 0xF8, 0x88, 0xF8, 0x88, 0x80, 0x74, 0x63, 0x08, 0x4E,
  0x31, 0x78, 0x8C, 0x63, 0x1F, 0xC6, 0x31, 0x88, 0xFF, 0x80, 0x08, 0x42,
  0x10, 0x84, 0x39, 0x70, 0x8E, 0x49, 0x28, 0xE3, 0xC9, 0x22, 0x8C, 0x88,
  0x88, 0x88, 0x88, 0xF0, 0x83, 0x8F, 0x1E, 0x3A, 0xB5, 0x6A, 0xC9, 0x92,
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
  {   176,   5,   9,   7,    1,   -8 },   // 0x47 'G'
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

const GFXfont RobotoCondensed_Regular6pt7b PROGMEM = {
  (uint8_t  *)RobotoCondensed_Regular6pt7bBitmaps,
  (GFXglyph *)RobotoCondensed_Regular6pt7bGlyphs,
  0x20, 0x7E, 14 };

// Approx. 1123 bytes

#endif
