BornaBiro/ESP32_WeatherPaper/Outdoor Unit Files/STM32 Code/Diplomski_Outdoor_Unit/Inc/main.h

#define EN_3V3SW_Pin GPIO_PIN_11
#define EN_3V3SW_GPIO_Port GPIOB
#define BAT_M_EN_Pin GPIO_PIN_9
#define BAT_M_EN_GPIO_Port GPIOA
#define WS_DIN_Pin GPIO_PIN_10
#define WS_DIN_GPIO_Port GPIOA
#define NRF24_CE_Pin GPIO_PIN_4
#define NRF24_CE_GPIO_Port GPIOB
#define SI1147_INT_Pin GPIO_PIN_5
#define SI1147_INT_GPIO_Port GPIOB
#define NRF24_CSN_Pin GPIO_PIN_6
#define NRF24_CSN_GPIO_Port GPIOB
#define SYNC_HEADER     0b00110101
#define DATA1_HEADER    0b00010001
#define DATA2_HEADER    0b00100010
