BornaBiro/ESP32_WeatherPaper/Indoor Unit Files/Arduino Code/Sketch/ESP32_WeatherPaper/communication.cpp

#include "communication.h"

communication::communication()
{

}

void communication::init(RF24_Inkplate * _rf, Inkplate *_dPtr, pcf85063 *_rtcPtr)
{
  _myRf = _rf;
  _d = _dPtr;
  _rtc = _rtcPtr;
}

void communication::setupCommunication()
{
  _myRf->setAutoAck(1);
  _myRf->enableAckPayload();
  _myRf->setChannel(0);
  _myRf->setDataRate(RF24_250KBPS);
  _myRf->setPALevel(RF24_PA_MAX, 1);
  _myRf->openWritingPipe(addr[1]);
  _myRf->openReadingPipe(1, addr[0]);
  _myRf->startListening();
}

uint8_t communication::sync(struct syncStructHandle *_s)
{
  // Wait for sync
  uint8_t syncOk = 0;
  uint8_t syncTimeout = 180;
  _d->clearDisplay();
  _d->display();
  while (!syncOk && syncTimeout != 0)
  {
    _d->clearDisplay();
    _d->setCursor(0, 100);
    _d->print("Sinkronizacija u tijeku, preostalo vrjeme: ");
    _d->print(syncTimeout--, DEC);
    _d->print('s');
    _d->partialUpdate(false, true);
    if (_myRf->available())
    {
      char temp[32];
      while (_myRf->available())
      {
        _myRf->read(temp, 32);
      }
      if (temp[0] == SYNC_HEADER)
      {
        *_s = makeSyncStruct();
        _myRf->writeAckPayload(1, _s, sizeof(syncStructHandle));
        syncOk = 1;
      }
    }
    delay(1000);
  }
  _d->clearDisplay();

  _myRf->flush_tx();
  _myRf->flush_rx();
  _myRf->powerDown();
  return syncOk;
}

uint8_t communication::getData(struct syncStructHandle *_s, struct measruementHandle *_h)
{
  _myRf->powerUp();
  delay(100);
  setupCommunication();
  struct data1StructHandle _d1 = {0};
  struct data2StructHandle _d2 = {0};

  uint8_t dataRx = 0;
  uint8_t rxTimeout = 25;
  while (dataRx != 3 && rxTimeout != 0)
  {
    if (_myRf->available())
    {
      char temp[32];
      while (_myRf->available())
      {
        _myRf->read(temp, 32);
      }
      if (temp[0] == DATA1_HEADER)
      {
        memcpy(&_d1, temp, sizeof(data1StructHandle));
        *_s = makeSyncStruct();
        _myRf->writeAckPayload(1, _s, sizeof(syncStructHandle));
        _h->humidity = _d1.humidity;
        _h->light = _d1.light;
        _h->pressure = _d1.pressure;
        _h->tempSHT = _d1.tempSHT;
        _h->tempSoil = _d1.tempSoil;
        _h->uv = _d1.uv / 100.0;
        _h->windDir = _d1.windDir;
        _h->windSpeed = _d1.windSpeed;
        dataRx |= 1;
      }
      if (temp[0] == DATA2_HEADER)
      {
        memcpy(&_d2, temp, sizeof(data2StructHandle));
        *_s = makeSyncStruct();
        _myRf->writeAckPayload(1, _s, sizeof(syncStructHandle));
        _h->battery = _d2.battery;
        _h->epoch = _d2.epoch;
        _h->rain = _d2.rain;
        _h->solarJ = _d2.solarJ;
        _h->solarW = _d2.solarW;
        dataRx |= 2;
      }
    }
    delay(1000);
    rxTimeout--;
  }
  *_s = makeSyncStruct();
  _myRf->flush_tx();
  _myRf->flush_rx();
  _myRf->powerDown();
  return dataRx;
}

uint8_t communication::saveDataToSD(struct sensorData *_s, struct measruementHandle* _d)
{
  SdFile _file;
  SdFat *_sd = _ink->getSdFat();
  char _tempStr[600];
  struct tm *_t;
  time_t _rtcEpoch;
  if (!_sd->begin(15, SD_SCK_MHZ(25))) return 0;
  if (_d != NULL)
  {
    _sd->chdir();

    _rtcEpoch = _rtc->getClock();
    getFolderPath(_tempStr, _rtcEpoch, COMMUNICATION_OUTDDOR);
    _sd->mkdir(_tempStr, true);
    _sd->chdir(_tempStr);

    // Create header on start of the file
    getFileNameFromEpoch(_tempStr, _rtcEpoch);
    if (!_file.exists(_tempStr))
    {
      _file.open(_tempStr, O_RDWR | O_CREAT);
      _file.println(_outdoorDataHeader);
      _file.close();
    }
    if (_file.open(_tempStr, O_RDWR | O_AT_END))
    {
      _rtcEpoch = _rtc->getClock();
      _t = localtime((time_t*) & (_rtcEpoch));
      _file.timestamp(T_ACCESS | T_CREATE | T_WRITE, _t->tm_year + 1900, _t->tm_mon + 1, _t->tm_mday, _t->tm_hour, _t->tm_min, _t->tm_sec);
      _rtcEpoch = (time_t)(_d->epoch);
      _t = localtime((const time_t*) & (_rtcEpoch));
      sprintf(_tempStr, _outdoorDataEntry, 0, _d->epoch, _t->tm_mday, _t->tm_mon + 1, _t->tm_year + 1900, _t->tm_hour, _t->tm_min, _t->tm_sec, _d->battery, _d->tempSHT, _d->tempSoil, _d->humidity, _d->pressure, _d->light, _d->uv / 100.0, _d->solarJ, _d->solarW, _d->windSpeed, _d->windDir, _d->rain);
      _file.println(_tempStr);
      _file.close();
    }
  }

  // Now store data from indoor unit
  _rtcEpoch = _rtc->getClock();
  getFolderPath(_tempStr, _rtcEpoch, COMMUNICATION_INDDOR);
  _sd->mkdir(_tempStr, true);
  _sd->chdir(_tempStr);

  getFileNameFromEpoch(_tempStr, _rtcEpoch);
  // Create header on start of the file
  if (!_file.exists(_tempStr))
  {
    _file.open(_tempStr, O_RDWR | O_CREAT);
    _file.println(_indoorDataHeader);
    _file.close();
  }
  if (_file.open(_tempStr, O_RDWR | O_AT_END))
  {
    _rtcEpoch = _rtc->getClock();
    _t = localtime((time_t*) & (_rtcEpoch));
    _file.timestamp(T_ACCESS | T_CREATE | T_WRITE, _t->tm_year + 1900, _t->tm_mon + 1, _t->tm_mday, _t->tm_hour, _t->tm_min, _t->tm_sec);
    _rtcEpoch = (time_t)(_s->epoch);
    _t = localtime((const time_t*) & (_rtcEpoch));
    sprintf(_tempStr, _indoorDataEntry, 0, _s->epoch, _t->tm_mday, _t->tm_mon + 1, _t->tm_year + 1900, _t->tm_hour, _t->tm_min, _t->tm_sec, _s->battery, _s->temp, _s->humidity, _s->pressure, _s->eco2, _s->tvoc, _s->rawH2, _s->rawEthanol);
    _file.println(_tempStr);
    _file.close();
  }
  return 1;
}

int16_t communication::getNumberOfEntries(time_t _epoch, uint8_t _indoor)
{
  int16_t _n = 0;
  SdFile _file;
  SdFat *_sd = _ink->getSdFat();
  struct tm *_t;
  char _temp[50];

  // Init SD card (just in case)
  if (!_sd->begin(15, SD_SCK_MHZ(25))) return -2;

  // Go to root
  _sd->chdir();

  _t = localtime((const time_t*)&_epoch);
  sprintf(_temp, _folderPath, _indoor == COMMUNICATION_INDDOR ? _folderIndoor : _folderOutdoor, _t->tm_year + 1900);
  if (!_sd->chdir(_temp)) return -2;

  sprintf(_temp, _filenameStr, _t->tm_mday, _t->tm_mon + 1, _t->tm_year + 1900);
  if (!_file.open(_temp, O_RDONLY))
  {
    _file.close();  
    return -1;
  }

  while (_file.available())
  {
    char c = _file.peek();
    if (c == '\n') _n++;
    _file.seekCur(1);
  }
  _file.close();
  return _n - 1;
}

uint8_t communication::getIndoorDataFromSD(time_t _epoch, int16_t _n, struct sensorData* _d)
{
  char _temp[100];
  SdFile _file;
  SdFat *_sd = _ink->getSdFat();

  // Init SD card (just in case)
  if (!_sd->begin(15, SD_SCK_MHZ(25))) return 0;

  // Go to root
  _sd->chdir();

  // Go inside indoor directory
  getFolderPath(_temp, _epoch, COMMUNICATION_INDDOR);
  if (!_sd->chdir(_temp)) return 0;

  // Open specific file
  getFileNameFromEpoch(_temp, _epoch);
  if (_file.open(_temp, O_RDONLY))
  {
    int _entries = 0;
    uint32_t *_dataStartPos = (uint32_t*)ps_malloc(sizeof(uint32_t) * (_n + 2));
    char *_oneLine = (char*)ps_malloc(sizeof(char) * (600));
    if (_dataStartPos == NULL || _oneLine == NULL)
    {
      free(_dataStartPos);
      free(_oneLine);
      _file.close();
      return 0;
    }

    // Find start of each new line
    _file.rewind();
    while (_file.available() && _entries < (_n + 1))
    {
      if (_file.read() == '\n')
      {
        _dataStartPos[_entries] = _file.curPosition();
        _entries++;
      }
    }

    if (_entries < _n) _n = _entries;
    
    for (int i = 0; i < _n; i++)
    {
      // Copy each line in buffer
      uint32_t _size = _dataStartPos[i + 1] - _dataStartPos[i] - 2;
      _file.seekSet(_dataStartPos[i]);
      _file.read(_oneLine, _size);
      _oneLine[_size] = 0;
      _oneLine[_size + 1] = '\r';
      _oneLine[_size + 2] = '\n';
      //Serial.println(_oneLine);
      int _dummy;
      // For some weird reason it wont copy directly in _d[i].timeStamp, so we have to use additional variable
      //int _tempEpoch;
      //_d[i].epoch = 1642447563ULL;
      sscanf(_oneLine, _indoorDataEntrySD, &_dummy, &(_d[i].epoch), &_dummy, &_dummy, &_dummy, &_dummy, &_dummy, &_dummy, &(_d[i].battery), &(_d[i].temp), &(_d[i].humidity), &(_d[i].pressure), &(_d[i].eco2), &(_d[i].tvoc), &(_d[i].rawH2), &(_d[i].rawEthanol));
      //_d[i].epoch = _tempEpoch;
      //Serial.println(_d[i].epoch);
    }
    free(_dataStartPos);
    free(_oneLine);
    _file.close();
    return 1;
  }
  return 0;
}

uint8_t communication::getOutdoorDataFromSD(time_t _epoch, int16_t _n, struct measruementHandle* _d)
{
  char _temp[100];
  SdFile _file;
  SdFat *_sd = _ink->getSdFat();

  // Init SD card (just in case)
  if (!_sd->begin(15, SD_SCK_MHZ(25))) return 0;

  // Go to root
  _sd->chdir();

  // Go inside outdoor directory
  getFolderPath(_temp, _epoch, COMMUNICATION_OUTDDOR);
  if (!_sd->chdir(_temp)) return 0;

  // Open specific file
  getFileNameFromEpoch(_temp, _epoch);
  if (_file.open(_temp, O_RDONLY))
  {
    int _entries = 0;
    uint32_t *_dataStartPos = (uint32_t*)ps_malloc(sizeof(uint32_t) * (_n + 2));
    char *_oneLine = (char*)ps_malloc(sizeof(char) * (600));
    if (_dataStartPos == NULL || _oneLine == NULL)
    {
      free(_dataStartPos);
      free(_oneLine);
      _file.close();  
      return 0;
    }

    // Find start of each new line
    _file.rewind();
    while (_file.available() && _entries < (_n + 1))
    {
      if (_file.read() == '\n')
      {
        _dataStartPos[_entries] = _file.curPosition();
        _entries++;
      }
    }

    if (_entries < _n) _n = _entries;
    
    for (int i = 0; i < _n; i++)
    {
      // Copy each line in buffer
      uint32_t _size = _dataStartPos[i + 1] - _dataStartPos[i] - 2;
      _file.seekSet(_dataStartPos[i]);
      _file.read(_oneLine, _size);
      
      _oneLine[_size] = 0;
      _oneLine[_size + 1] = '\r';
      _oneLine[_size + 2] = '\n';
      float _uv;
      int _dummy;
      sscanf(_oneLine, _outdoorDataEntrySD, &_dummy, &(_d[i].epoch), &_dummy, &_dummy, &_dummy, &_dummy, &_dummy, &_dummy, &(_d[i].battery), &(_d[i].tempSHT), &(_d[i].tempSoil), &(_d[i].humidity), &( _d[i].pressure), &(_d[i].light), &_uv, &( _d[i].solarJ), &(_d[i].solarW), &(_d[i].windSpeed), &(_d[i].windDir), &(_d[i].rain));
      _d[i].uv = _uv * 100;
    }
    free(_dataStartPos);
    free(_oneLine);
    _file.close();
    return 1;
  }
  return 0;
}

void communication::getFileNameFromEpoch(char *_s, time_t _epoch)
{
  struct tm *_t;
  _t = localtime((const time_t*)&_epoch);
  sprintf(_s, _filenameStr, _t->tm_mday, _t->tm_mon + 1, _t->tm_year + 1900);
}

void communication::getFolderPath(char *_s, time_t _epoch, uint8_t _indoor)
{
  struct tm *_t;
  char _tempFileStr[40];
  _t = localtime((const time_t*)&_epoch);
  sprintf(_s, _folderPath, _indoor == COMMUNICATION_INDDOR ? _folderIndoor : _folderOutdoor, _t->tm_year + 1900);
}

struct syncStructHandle communication::makeSyncStruct()
{
  syncStructHandle _s = {SYNC_HEADER};
  _s.myEpoch = _rtc->getClock();
  _s.sendEpoch = newWakeupTime((time_t)_s.myEpoch);
  return _s;
}

time_t communication::newWakeupTime(time_t _current)
{
  struct tm _myTime;
  time_t _alarmEpoch;
  memset(&_myTime, 0, sizeof(_myTime));
  memcpy(&_myTime, localtime((const time_t *) &_current), sizeof (_myTime));

  int minutes = (int)(ceil(((double) (_myTime.tm_min) + ((double) (_myTime.tm_sec) / 60)) / WAKEUP_INTERVAL) * WAKEUP_INTERVAL);
  _myTime.tm_min = minutes % 60;
  _myTime.tm_sec = 0;
  _alarmEpoch = mktime(&_myTime);

  if (minutes >= 60) _alarmEpoch += 3600;
  return _alarmEpoch;
}
