BornaBiro/ESP32_WeatherPaper/Indoor Unit Files/Arduino Code/Sketch/ESP32_WeatherPaper/icons.h

#ifndef __ICONS_H__
#define __ICONS_H__

//https://www.skaarhoj.com/FreeStuff/GraphicDisplayImageConverter.php

//40x40
static const uint8_t iconTemp[] PROGMEM = {
  0x00, 0x00, 0x78, 0x00, 0x00, 0x00, 0x00, 0x84, 0x00, 0x00, 0x00, 0x00, 0x84, 0xfe, 0x00, 0x00, 0x00, 0x84, 0x00, 0x00, 0x00, 0x00, 0x84, 0x00, 0x00, 0x00, 0x00, 0x84, 0xc0, 0x00, 0x00, 0x00, 0x84, 0x00, 0x00, 0x00, 0x00, 0x84, 0x00, 0x00, 0x00, 0x00, 0x84, 0x00, 0x00, 0x00, 0x00, 0xb4, 0xc0, 0x00, 0x00, 0x00, 0xb4, 0x00, 0x00, 0x00, 0x00, 0xb4, 0x00, 0x00, 0x00, 0x00, 0xb4, 0xfe, 0x00, 0x00, 0x00, 0xb4, 0x00, 0x00, 0x00, 0x00, 0xb4, 0x00, 0x00, 0x00, 0x00, 0xb4, 0xc0, 0x00, 0x00, 0x00, 0xb4, 0x00, 0x00, 0x00, 0x00, 0xb4, 0x00, 0x00, 0x00, 0x00, 0xb4, 0x00, 0x00, 0x00, 0x00, 0xb4, 0xc0, 0x00, 0x00, 0x00, 0xb4, 0x00, 0x00, 0x00, 0x00, 0xb4, 0x00, 0x00, 0x00, 0x00, 0xb4, 0xfe, 0x00, 0x00, 0x00, 0xb4, 0x00, 0x00, 0x00, 0x00, 0xb4, 0x00, 0x00, 0x00, 0x01, 0x32, 0x00, 0x00, 0x00, 0x06, 0x31, 0x80, 0x00, 0x00, 0x04, 0x78, 0x80, 0x00, 0x00, 0x09, 0xfe, 0x40, 0x00, 0x00, 0x11, 0xfe, 0x40, 0x00, 0x00, 0x13, 0xff, 0x20, 0x00, 0x00, 0x13, 0xff, 0x20, 0x00, 0x00, 0x13, 0xff, 0x20, 0x00, 0x00, 0x11, 0xfe, 0x20, 0x00, 0x00, 0x11, 0xfe, 0x40, 0x00, 0x00, 0x08, 0x78, 0x40, 0x00, 0x00, 0x04, 0x00, 0x80, 0x00, 0x00, 0x06, 0x01, 0x80, 0x00, 0x00, 0x01, 0x86, 0x00, 0x00, 0x00, 0x00, 0x78, 0x00, 0x00
};

//40x40
static const uint8_t iconTlak[] PROGMEM = {
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
  0x1c,0x08,0x20,0xe1,0xf8,
  0x1c,0x08,0x20,0xe0,0xf8,
  0x1c,0x0e,0x20,0xe0,0x78,
  0x1c,0x08,0x20,0xe0,0x38,
  0x1c,0x08,0x20,0xe0,0x00,
  0x1c,0x08,0x20,0xe0,0x00,
  0x1c,0x08,0x20,0xe0,0x00,
  0x1c,0x08,0x20,0xe0,0x00,
  0x1f,0xff,0xff,0xe0,0x00,
  0x1f,0xff,0xff,0xe0,0x00,  
};

#endif
