BornaBiro/ESP32_WeatherPaper/Indoor Unit Files/Arduino Code/Sketch/ESP32_WeatherPaper/Neucha_Regular17pt7b.h

#ifndef __NEUCHA_REGULAR17PT7B_H__
#define __NEUCHA_REGULAR17PT7B_H__

const uint8_t Neucha_Regular17pt7bBitmaps[] PROGMEM = {
  0xDB, 0x6D, 0xB6, 0xDB, 0x6D, 0xB2, 0x48, 0x0D, 0xFB, 0xCD, 0xDF, 0xBF,
  0x7C, 0xC8, 0x91, 0x00, 0x00, 0x60, 0x60, 0x06, 0x06, 0x00, 0x30, 0x30,
  0x01, 0x81, 0x80, 0x08, 0x18, 0x00, 0xC0, 0xC1, 0x06, 0x06, 0x0F, 0xFF,
  0xF8, 0x3F, 0xFF, 0xF8, 0x18, 0x18, 0x00, 0xC0, 0x80, 0x0C, 0x0C, 0x00,
  0x60, 0x60, 0x7F, 0xFF, 0xF3, 0xFF, 0xFF, 0x81, 0x81, 0x80, 0x0C, 0x0C,
  0x00, 0xC0, 0xC0, 0x06, 0x06, 0x00, 0x30, 0x30, 0x01, 0x81, 0x80, 0x18,
  0x18, 0x00, 0xC0, 0xC0, 0x00, 0x02, 0x00, 0x08, 0x01, 0xF0, 0x0F, 0xFC,
  0x72, 0x3B, 0x88, 0x0C, 0x20, 0x30, 0x80, 0xC2, 0x03, 0x0C, 0x06, 0x30,
  0x1C, 0xC0, 0x3F, 0x00, 0x7C, 0x00, 0x3C, 0x00, 0xF8, 0x03, 0x70, 0x0C,
  0xE0, 0x31, 0x80, 0xC3, 0x03, 0x0C, 0x0C, 0x30, 0x30, 0xC0, 0xC7, 0x63,
  0x79, 0xFF, 0xC0, 0xFE, 0x00, 0xC0, 0x03, 0x00, 0x1E, 0x00, 0x01, 0xF8,
  0x02, 0x1C, 0x60, 0x39, 0xC3, 0x81, 0x8C, 0x0C, 0x1C, 0x60, 0x60, 0xC3,
  0x03, 0x0C, 0x1C, 0x38, 0xE0, 0x71, 0x86, 0x01, 0xF8, 0x70, 0x07, 0x87,
  0x00, 0x00, 0x30, 0x00, 0x03, 0x80, 0x00, 0x38, 0x00, 0x01, 0x80, 0x00,
  0x1C, 0x00, 0x01, 0xC3, 0xC0, 0x0C, 0x3F, 0x00, 0xE3, 0x8C, 0x0E, 0x38,
  0x70, 0xF1, 0x81, 0x87, 0x0C, 0x0C, 0x70, 0x60, 0x67, 0x83, 0x07, 0x38,
  0x0C, 0x31, 0xC0, 0x3F, 0x00, 0x00, 0xF0, 0x07, 0xE0, 0x07, 0xF8, 0x03,
  0xC0, 0x00, 0xC0, 0x00, 0x60, 0x00, 0x18, 0x00, 0x86, 0x00, 0x21, 0x80,
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
  {  1266,  13,  23,  15,    2,  -22 },   // 0x46 'F'
  {  1304,  16,  25,  19,    1,  -23 },   // 0x47 'G'
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

const GFXfont Neucha_Regular17pt7b PROGMEM = {
  (uint8_t  *)Neucha_Regular17pt7bBitmaps,
  (GFXglyph *)Neucha_Regular17pt7bGlyphs,
  0x20, 0x7E, 37 };

// Approx. 3870 bytes

#endif
