BornaBiro/ESP32_WeatherPaper/Outdoor Unit Files/STM32 Code/Diplomski_Outdoor_Unit/myDrivers/Inc/RF24_config.h

/*
 Copyright (C)
    2011            J. Coliz <maniacbug@ymail.com>
    2015-2019 TMRh20
    2015            spaniakos <spaniakos@gmail.com>
    2015            nerdralph
    2015            zador-blood-stained
    2016            akatran
    2017-2019 Avamander <avamander@gmail.com>
    2019            IkpeohaGodson

 This program is free software; you can redistribute it and/or
 modify it under the terms of the GNU General Public License
 version 2 as published by the Free Software Foundation.
*/

#ifndef __RF24_CONFIG_H__
#define __RF24_CONFIG_H__

/*** USER DEFINES:    ***/
#define FAILURE_HANDLING

/**
 * User access to internally used delay time (in microseconds) during RF24::powerUp()
 * @warning This default value compensates for all supported hardware. Only adjust this if you
 * know your radio's hardware is, in fact, genuine and reliable.
 */
#if !defined(RF24_POWERUP_DELAY)
#define RF24_POWERUP_DELAY  5000
#endif

/**********************/
#define rf24_max(a, b) (a>b?a:b)
#define rf24_min(a, b) (a<b?a:b)


#include <stdint.h>
#include <stdio.h>

#ifndef _BV
    #define _BV(x) (1<<(x))
#endif

#endif // __RF24_CONFIG_H__
