BornaBiro/ESP32_WeatherPaper/Outdoor Unit Files/STM32 Code/Diplomski_Outdoor_Unit/myDrivers/Inc/SHT21.h

#ifndef __SHT21_H__
#define __SHT21_H__

#include "stdint.h"
#include "stm32l0xx_hal.h"

#define SHT21_ADDRESS					0x80
#define SHT21_TRIG_TEMP_MEAS_NO_HOLD	0b11110011
#define SHT21_TRIG_HUM_MEAS_NO_HOLD		0b11110101

uint8_t SHT21_Init();
uint16_t SHT21_ReadRegister(uint8_t _reg);
float SHT21_ReadHumidity();
float SHT21_ReadTemperature();

#endif
