BornaBiro/ESP32_WeatherPaper/Indoor Unit Files/Arduino Code/Sketch/ESP32_WeatherPaper/timeAndDate.h

#ifndef __TIMEANDDATE_H__
#define __TIMEANDDATE_H__

#include "time.h"
#include "sys/time.h"

static const char DOW[7][4] = {"NED", "PON", "UTO", "SRI", "CET", "PET", "SUB"};

static struct tm epochToHuman(time_t _t)
{
  struct tm _time;
  memcpy(&_time, localtime(&_t), sizeof(_time));
  return _time;
}

#endif
