BornaBiro/ESP32_WeatherPaper/Indoor Unit Files/Arduino Code/Sketch/ESP32_WeatherPaper/Weather.h

#ifndef __WEATHER_H___
#define __WEATHER_H___

#include "structs.h"
#include <HTTPClient.h>
#include <WiFiClient.h>
#include <ArduinoJson.h>
#include "timeAndDate.h"

class OWMWeather
{
    public:
    OWMWeather();
    uint8_t getCurrentWeather(const char* _url, struct currentWeatherHandle *_c);
    uint8_t getForecastWeather(const char* _url, struct forecastListHandle *_f, struct forecastDisplayHandle *_d);
    uint8_t oneCall(const char *_url, oneCallApiHandle *_o);
    void removeCroLetters(char *p);
};

#endif
