BornaBiro/ESP32_WeatherPaper/(commit log)

2019-09-30 New Font, touchscreen functions, added wind dir
    Added new font into Sketch, add low power capability, refresh on demand, new function for epoch to time conversion, new touch functions (for 10 inch resistive touch), wind direction indicator and bug fixes.
    [ESP32_WeatherPaper.ino, Neucha_Regular17pt7b.h, icons.h]
2021-03-19 Test codes: Keyboard & textbox - Almost full functionality of textbox
    Textbox is now working. Still there is still some issues on selecting end of string with touch. And there should be added arrows for navigation though textbox/string.
    [Inkplate_keyboard_textbox.ino]
2021-09-27 RTC used for clock instead or NTP every time it refreshes, added file for all structs, added code for converting epoch to human T&D, minor code cleanup, sensor struct, better NTP
2021-09-29 More code cleanup, better parsing current weather data, new structs for current weather and forecast
2021-09-30 Transferred openWeatherMaps API functions into library, added function for touch detection in some area, added rounding for temperature, replaced back button position for selected day, structs moved 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
    [ESP32_WeatherPaper.ino, RobotoCondensed_Regular6pt7b.h, Weather.cpp, Weather.h, icons.h, structs.h]
2021-10-01 Added separate files for GUI elements (drawing elements on screen) and for time and date, fixed multiple definitions for icons and fonts, added calculations for avg. wind speed and dir., different BM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
    [ESP32_WeatherPaper.ino, GUI.cpp, GUI.h, Neucha_Regular17pt7b.h, RobotoCondensed_Regular6pt7b.h, Weather.cpp, Weather.h, icons.h]
2021-10-01 Fixed bug in avg. wind dir., global Inkplate object in GUI library (also added GUI::init() function), added new icons for buttons (UV, light and solar irradiated power are missing), fixed forecast (n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
    [ESP32_WeatherPaper.ino, GUI.cpp, GUI.h, Weather.cpp, icons.h, structs.h]
2021-10-26 New graphs, new and improved GUI, added external RTC, modified code for new board and board addon (with sensors, TS controller and RTC)
2021-10-26 Added RF communication (just sync for now), fixed graphs (added manual scaling)
    [ESP32_WeatherPaper.ino, communication.cpp, communication.h, structs.h]
2021-10-26 Added function for getting data from RF, fixed bug with RF and touch collision (PB7 on MCP was set to HIGH in loop)
    [ESP32_WeatherPaper.ino, GUI.cpp, GUI.h, PCF85063.cpp, PCF85063.h, communication.cpp, communication.h]
2021-10-27 Fixed bug with getting data from SD card, added displaying outdoor data on graph.
    [ESP32_WeatherPaper.ino, GUI.cpp, GUI.h, communication.cpp, communication.h, structs.h]
2021-10-27 Fix on init of TSC2046 driver
2021-10-28 Bug fixes includes that includes UV bug, indoor graph bug, clock bug. Added CO2 readings, added battery measurement, added icons on graphs, added selectable graphs
    [ESP32_WeatherPaper.ino, GUI.cpp, GUI.h, PCF85063.cpp, communication.cpp, communication.h, icons.h, structs.h]
2021-10-28 Added button for sync and for NTP Clock Sync
2021-10-29 Added comments, added graph rewind / forward, added showing all measured data on main screen, added WiFi connection timeout, fixed eeprom wakeup (pointers)
    [ESP32_WeatherPaper.ino, GUI.cpp, GUI.h]
2021-11-29 First final version, added .gitignore, added partial updates, fixed bug in forced NTP clock sync, added debug messages
    [ESP32_WeatherPaper.ino]
2021-11-29 Split files into folders, added FreeCAD models, added STL files, added PCB files
    [Indoor_unit_IO_board.brd, Indoor_unit_IO_board.sch, Indoor_unit_solar.FCStd, Indoor_unit_solar.stl, epaperFrameBackCover.FCStd, epaperFrameBackCover.stl, epaperFrameV5.FCStd, epaperFrameV5.stl]
2022-06-14 RTC and time fix, new wake up time,
    Wake up every 5 minutes.
    [ESP32_WeatherPaper.ino, GUI.cpp, GUI.h, PCF85063.cpp, PCF85063.h, Weather.cpp, communication.cpp, communication.h]
2022-06-14 CO2 sensor is read every 30 minutes (like weather from Internet)
2022-06-14 Better low power mode I guess?
2022-08-17 Fixed semi-random crashes while fetching and parsing weather data.
    Usually ESP32 crashes every day between 22:00h and 23:00. There was a issue on divide by zero in Weather.cpp, line "_d[i].avgPressure /= nElements".
    [ESP32_WeatherPaper.ino, Weather.cpp, communication.cpp]
2022-09-30 Fixed not waking up at the start of the month.
    [PCF85063.cpp]
2022-11-02 Embarrassing mistake while reading and setting RTC month.
    [PCF85063.cpp]
2023-01-04 Files moved
    [Indoor_unit_IO_board.brd, Indoor_unit_IO_board.sch, Indoor_unit_solar.FCStd, Indoor_unit_solar.stl, epaperFrameBackCover.FCStd, epaperFrameBackCover.stl, epaperFrameV5.FCStd, epaperFrameV5.stl]
2023-01-04 Added outdoor unit files, added images.
    [Ball_joint1.FCStd, Ball_joint2.FCStd, LCD_Board.brd, LCD_Board.sch, Outdoor_solar_panel.FCStd, Outdoor_unit_T_H_P_Board.brd, Outdoor_unit_T_H_P_Board.sch, Outdoor_unit_light_board.brd]
